tardani95/micromouse_2019/README.md

View this project on [CADLAB.io](https://cadlab.io/project/1610). 

micromouse_2019
