tardani95/micromouse_2019/01_datasheet/imu/schematic.JPG

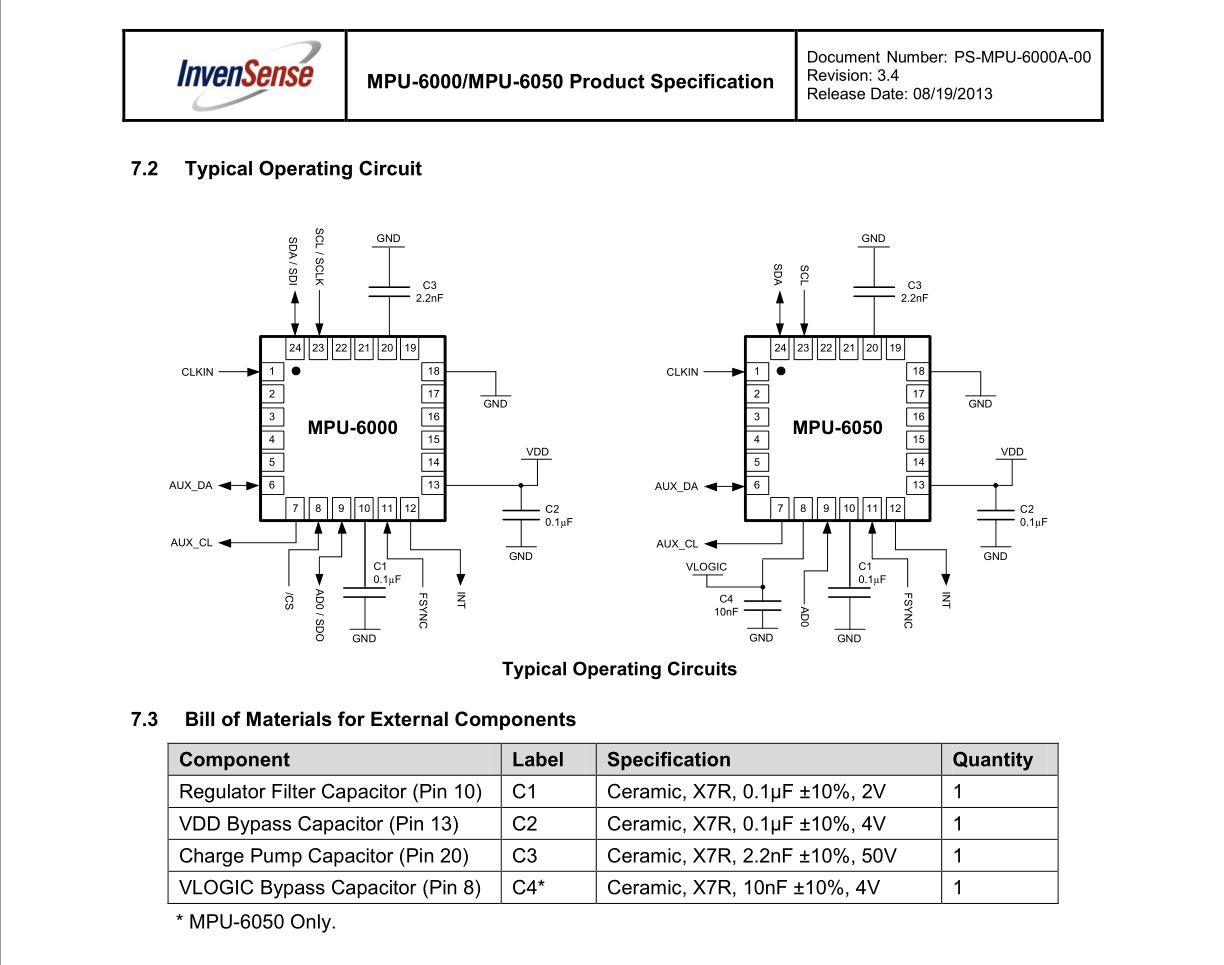
01_datasheet/imu/schematic.JPG
