tardani95/micromouse_2019/01_datasheet/wireless_modul/wifi/esp-12e_pinout.png

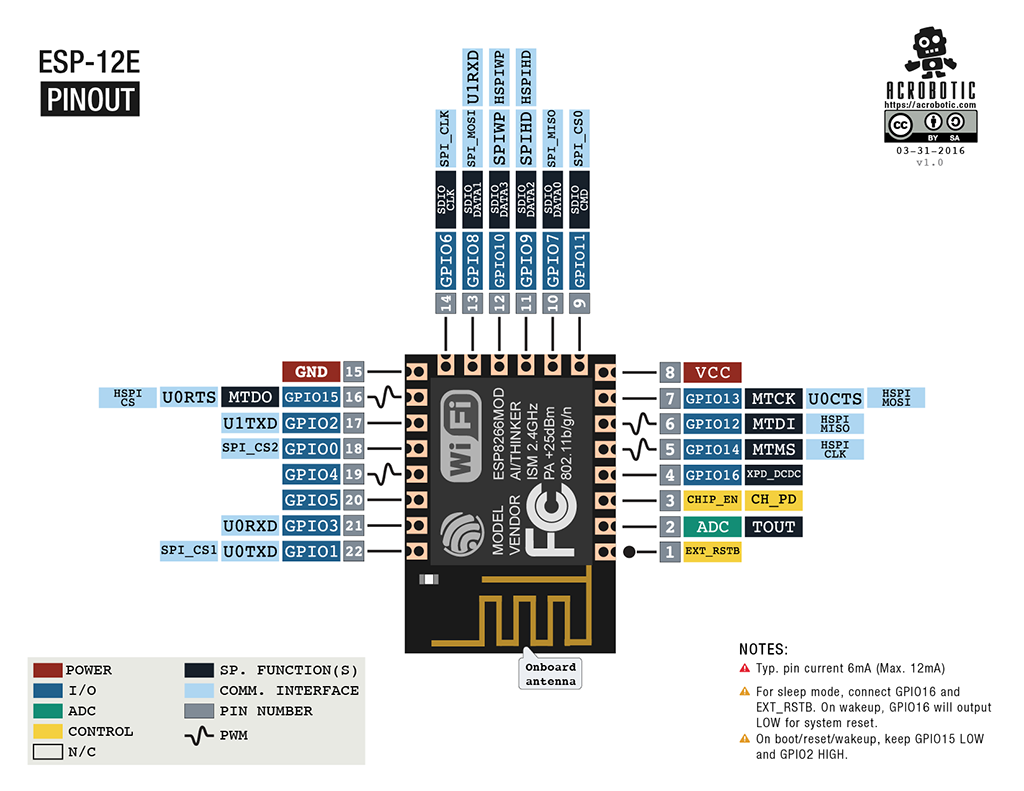
01_datasheet/wireless_modul/wifi/esp-12e_pinout.png
