tardani95/micromouse_2019/03_software/embedded_sw_SPL_C/doc/waldlaeufer_after_run_menu.png

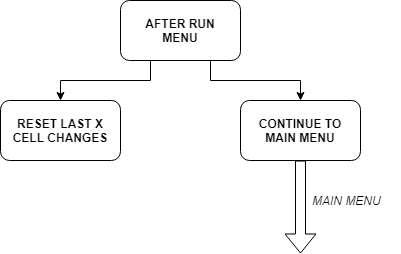
03_software/embedded_sw_SPL_C/doc/waldlaeufer_after_run_menu.png
