tardani95/micromouse_2019/01_datasheet/connectors/connectors.xlsx

 | minek |  |  | nyak |  |  |  | kabel
 | 4x1 - IR_PTR |  |  | BM04B-SRSS-TB (https://lcsc.com/product-detail/Others_JST-Sales-America__JST-Sales-America-BM04B-SRSS-TB-LF-SN_C160390.html) |  |  |  | 04SUR-32S (https://lcsc.com/product-detail/Others_JST-Sales-America_04SUR-32S_JST-Sales-America-04SUR-32S_C160292.html)
 | LCSC Part Number | Manufacture Part Number | Manufacturer | Package | Description | RoHS | Order Qty. | Min\Mult Order Qty. | Unit Price | Order Price | Product Link
conn_motor_wire | C82373 | 02SR-3S | JST Sales America | Piercing connector | PCB Connectors - Headers, Receptacles, Female Sockets Piercing connector RoHS | yes | 10 | 5\5 | 0.1088 | 1.088 | https://lcsc.com/product-detail/Connectors_JST-Sales-America_02SR-3S_JST-Sales-America-02SR-3S_C82373.html
conn_swd_wire | C268118 | 03SR-3S | JST Sales America | P=1mm | PCB Connectors - Headers, Receptacles, Female Sockets P=1mm RoHS | yes | 1 | 1\1 | 0.14 | 0.14 | https://lcsc.com/product-detail/Others_JST-Sales-America_03SR-3S_JST-Sales-America-03SR-3S_C268118.html
conn_batt | C131337 | B2B-PH-K-S(LF)(SN) | JST Sales America | Plugin | PCB Connectors - Headers, Male Pins Plugin RoHS | yes | 5 | 5\5 | 0.1109 | 0.5545 | https://lcsc.com/product-detail/PCB-Connectors-Headers-Male-Pins_JST-Sales-America_B2B-PH-K-S-LF-SN_JST-Sales-America-B2B-PH-K-S-LF-SN_C131337.html
conn_motor_pcb | C160388 | BM02B-SRSS-TB(LF)(SN) | JST Sales America | SMD,P=1mm | PCB Connectors - Headers, Male Pins SMD,P=1mm RoHS | yes | 10 | 1\1 | 0.1305 | 1.305 | https://lcsc.com/product-detail/_JST_BM02B-SRSS-TB-LF-SN_BM02B-SRSS-TB-LF-SN_C160388.html
conn_swd_pcb | C160403 | SM03B-SRSS-TB(LF)(SN)(P) | JST Sales America | - | PCB Connectors - Headers, Male Pins RoHS | yes | 6 | 1\1 | 0.183 | 1.098 | https://lcsc.com/product-detail/Others_JST-Sales-America__JST-Sales-America-SM03B-SRSS-TB-LF-SN-P_C160403.html
stm32f415rg | C124726 | STM32F415RGT6 | STMicroelectronics | LQFP-64_10x10x05P | ST Microelectronics LQFP-64_10x10x05P RoHS | yes | 3 | 1\1 | 7.9466 | 23.8398 | https://lcsc.com/product-detail/ST-Microelectronics_STMicroelectronics_STM32F415RGT6_STM32F415RGT6_C124726.html
backup_IR_led | C111836 | TSAL6100 | Vishay Intertech | Plugin | Infrared (IR) LEDs Plugin RoHS | yes | 10 | 1\1 | 0.0939 | 0.939 | https://lcsc.com/product-detail/Infrared-IR-LEDs_VISHAY_TSAL6100_TSAL6100_C111836.html
 | for daniel tar
testclips | C99184 | 20.135.5 | Changzhou Amass Elec | Test Clip | Test Clips Test Clip RoHS | yes | 1 | 1\1 | 0.5011 | 0.5011 | https://lcsc.com/product-detail/Test-Clips_Changzhou-Amass-Elec-20-135-5_C99184.html
testclips | C99180 | 20.135.1 | Changzhou Amass Elec | Test Clip | Test Clips Test Clip RoHS | yes | 1 | 1\1 | 0.5043 | 0.5043 | https://lcsc.com/product-detail/Test-Clips_Changzhou-Amass-Elec-20-135-1_C99180.html
testclips | C99182 | 20.135.3 | Changzhou Amass Elec | Test Clip | Test Clips Test Clip RoHS | yes | 1 | 1\1 | 0.5027 | 0.5027 | https://lcsc.com/product-detail/Test-Clips_Changzhou-Amass-Elec-20-135-3_C99182.html
testclips | C99183 | 20.135.4 | Changzhou Amass Elec | Test Clip | Test Clips Test Clip RoHS | yes | 1 | 1\1 | 0.5091 | 0.5091 | https://lcsc.com/product-detail/Test-Clips_Changzhou-Amass-Elec-20-135-4_C99183.html
testclips | C99181 | 20.135.2 | Changzhou Amass Elec | Test Clip | Test Clips Test Clip RoHS | yes | 1 | 1\1 | 0.517 | 0.517 | https://lcsc.com/product-detail/Test-Clips_Changzhou-Amass-Elec-20-135-2_C99181.html
