tardani95/micromouse_2019/01_datasheet/encoder/encoders_comparison.xlsx

AMS Magnetic Rotary Position Sensors
Criteria: | Available on Mouser, ABI, >4000 rpm
Model | Resolution | DAEC | Package | Mouser Stock | Mouser Price (EUR) | AMS Sample | Notes
AS5045B | 4096 | No | SSOP-16 | 399 | 12.9 | 0 | currently used
AS5601 | 2048 | No | SOIC-8 | 3424 | 4.06 | 5 | maximum 456 rpm in ABI Mode (Datasheet Page 7)
AS5040 | 1024 | No | SSOP-16 | 12793 | 11.75 | 3
AS5047D | 2048 | Yes | TSSOP-14 | 2758 | 9.44 | 4 | external stray field compensation
