tardani95/micromouse_2019/01_datasheet/wireless_modul/bluetooth/_bluetooth_modules.xlsx

mfr. No. | distributor | price (without TAX) | delivery | datasheet | voltage supply | dimensons (mm) | notes
BH661C-503 | mouser | 8,33 EUR | 7000 HUF | BH661C-503 Datasheet (https://hu.mouser.com/datasheet/2/915/BlueFanBH661C_2bdatasheets-1360478.pdf) | 3.3 V | 11. 0 x 16.7 x 1.9 | dual mode Bluetooth v4.2 with SPP
SPBT3.0DP2 | arrow | 13 EUR | free | datasheet (http://static6.arrow.com/aropdfconversion/2660c6c649f2dce07df3621c833661d77cad4fe4/128279822216958344.pdf) | 3.3 V | 11.6 x 13.5 x 2.9 | Bluetooth v3.0 with SPP
BT33LT (https://www.arrow.de/de-DE/products/bt33lt/amped-rf-technology/) | arrow | 11,09 EUR | free | datasheet (http://static6.arrow.com/aropdfconversion/d2f114f954caf3751a445e852f3ba5c5ad842af6/8890309385789139bt33_datasheet.pdf) | 2.5 V tolarates 3.3V
SPBT2632C2A.AT2 | rs-online | 3300 HUF | 1000 HUF | datasheet (https://docs-emea.rs-online.com/webdocs/1282/0900766b81282479.pdf) | 2.5 V tolarates 3.3V | 11.6 x 13.5 x 2.9 | Bluetooth v3.0 with SPP | Varga Andris-e
JDY-10 | ebay | alredy paid | arrived | not available | 3.3 V | 13.0 x 18.7 x 3.0 | BLE 4.0, no SPP
