tardani95/micromouse_2019/07_3D/gearbox/_ASSEMBLY_getriebe_rechts.SLDASM

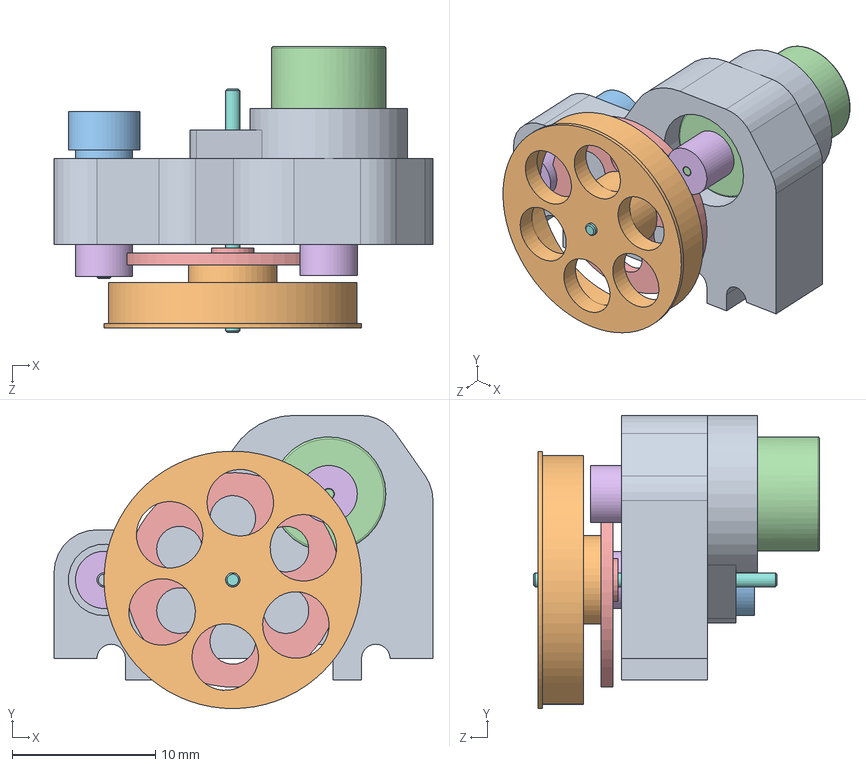
[picture p5: CAD file, 2019-02-14]
07_3D/gearbox/_ASSEMBLY_getriebe_rechts.SLDASM
26.5 x 20.5 x 20.0 mm
getriebe_gehause_rechts
magnetscheibe
magnettraeger
MK06_4R5_1
grossRad
ritzel x 2
rillenkugellager_6488 x 4
hauptWelle
nebenWelle
rad
