tardani95/micromouse_2019/07_3D/3d_print/getriebe_gehause_rechts_2.STEP

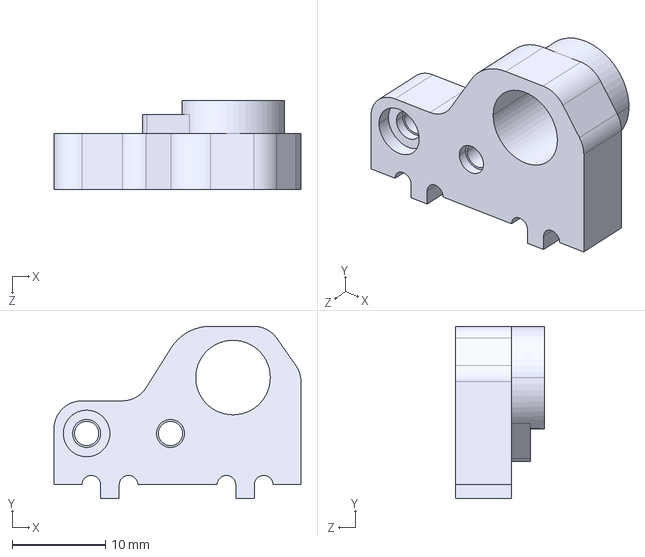
[picture p6: CAD file, 2019-02-14]
07_3D/3d_print/getriebe_gehause_rechts_2.STEP
26.5 x 18.5 x 9.50 mm
