tardani95/micromouse_2019/07_3D/cnc_milling/haz/getriebe_gehause_links_1.STEP

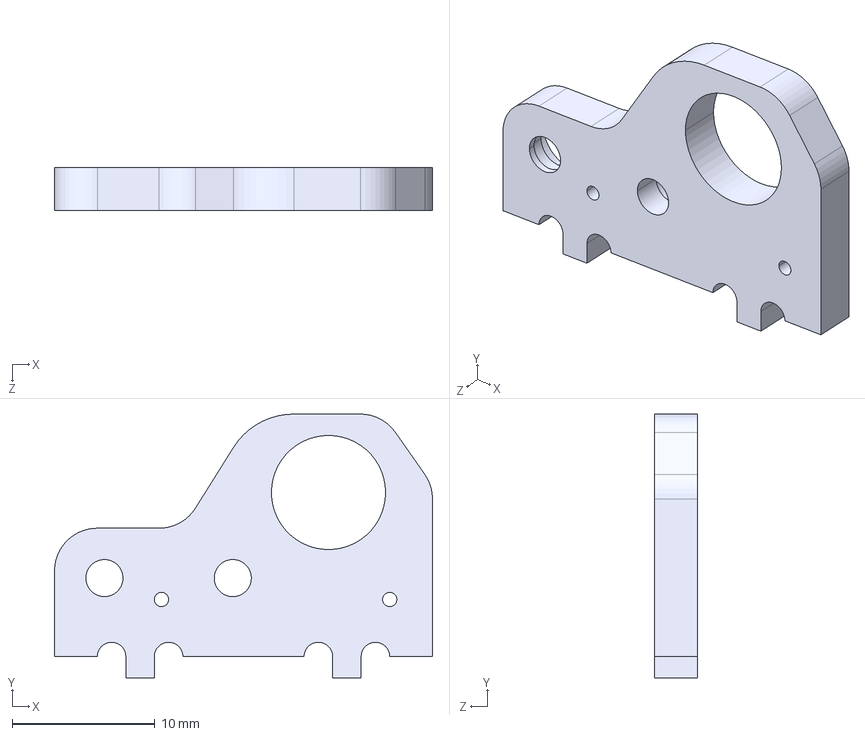
[picture p7: CAD file, 2019-02-14]
07_3D/cnc_milling/haz/getriebe_gehause_links_1.STEP
26.5 x 18.5 x 3.00 mm
