tardani95/micromouse_2019/07_3D/cnc_milling/kerek/rad.SLDPRT

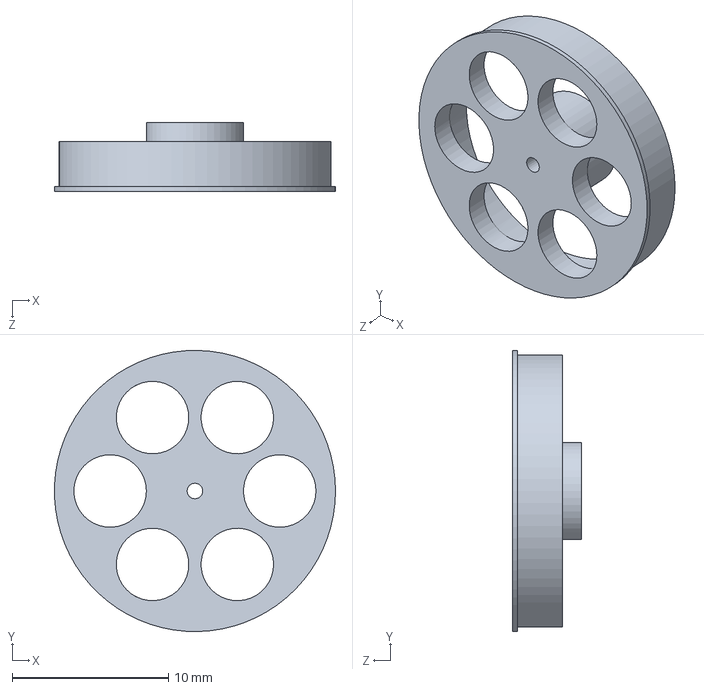
[picture p8: CAD file, 2019-02-14]
07_3D/cnc_milling/kerek/rad.SLDPRT
18.0 x 18.0 x 4.40 mm
