tardani95/micromouse_2019/07_3D/cnc_milling/magnestarto/magnettraeger_aussen.SLDPRT

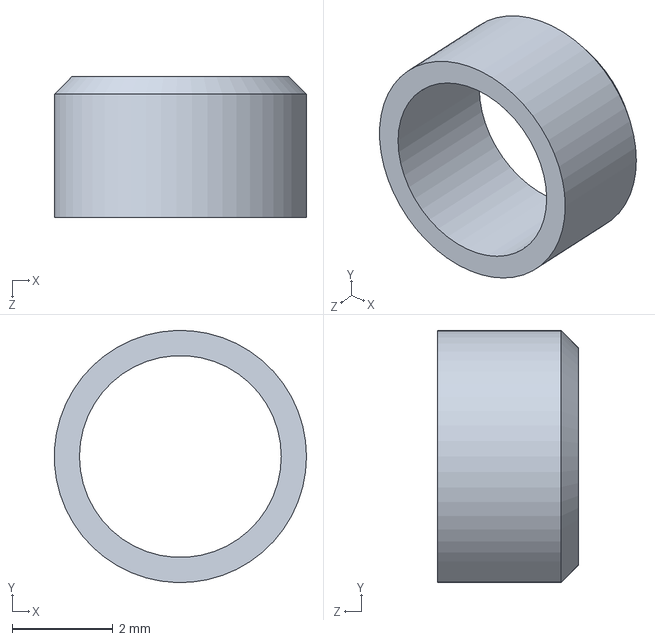
[picture p9: CAD file, 2019-02-14]
07_3D/cnc_milling/magnestarto/magnettraeger_aussen.SLDPRT
5.00 x 5.00 x 2.80 mm
