tardani95/micromouse_2019/07_3D/cnc_milling/STEP_fajlok/magnettraeger_innen.STEP

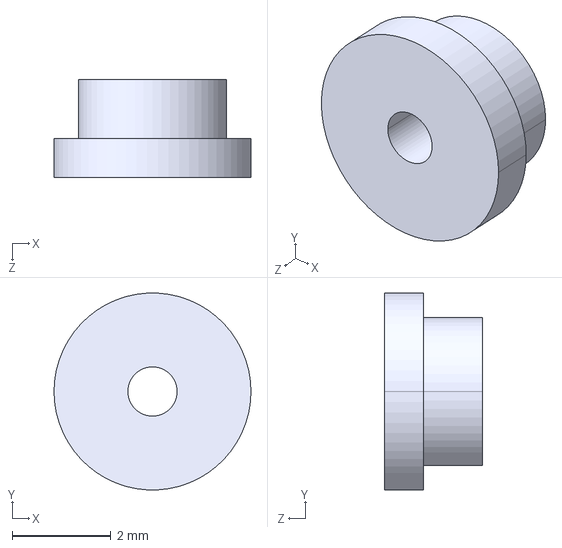
[picture p10: CAD file, 2019-02-14]
07_3D/cnc_milling/STEP_fajlok/magnettraeger_innen.STEP
4.00 x 3.99 x 2.00 mm
