tardani95/micromouse_2019/07_3D/electronic_components/buttons/B3U-3000P.stp

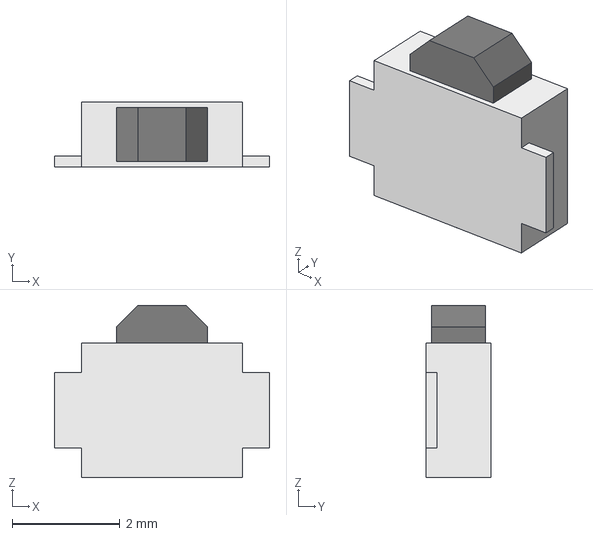
[picture p11: CAD file, 2019-02-14]
07_3D/electronic_components/buttons/B3U-3000P.stp
4.00 x 1.20 x 3.20 mm
