tardani95/micromouse_2019/07_3D/electronic_components/connectors/04SR-3S.STEP

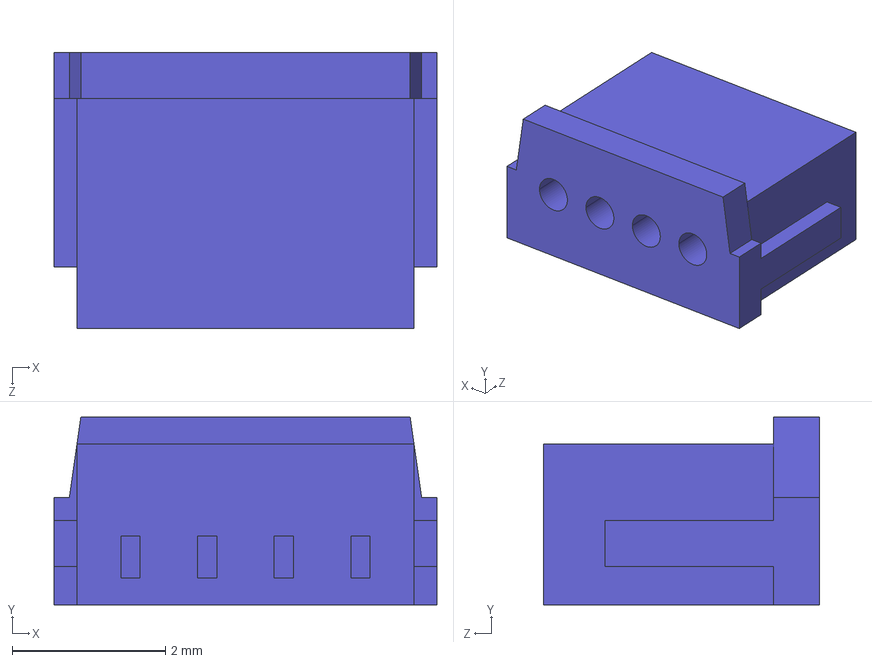
[picture p12: CAD file, 2019-02-21]
07_3D/electronic_components/connectors/04SR-3S.STEP
5.00 x 2.45 x 3.60 mm
