tardani95/micromouse_2019/07_3D/electronic_components/drv8836/DRV8836DSSR.stp

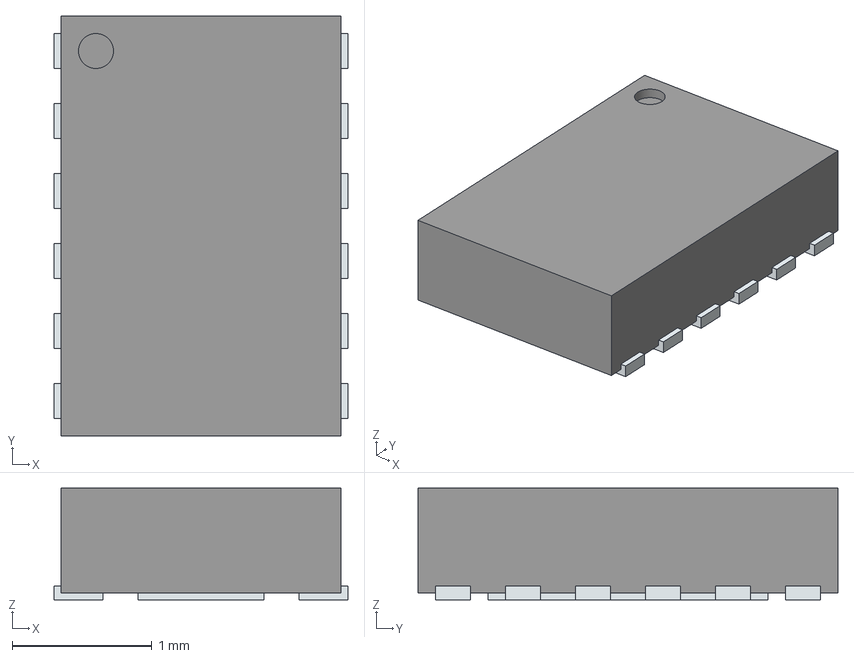
[picture p13: CAD file, 2019-02-14]
07_3D/electronic_components/drv8836/DRV8836DSSR.stp
2.10 x 3.00 x 0.8 mm
ThermalPin
PinsArrayLR
