tardani95/micromouse_2019/07_3D/electronic_components/encoder_modul/micromouse2019_enc v7.step

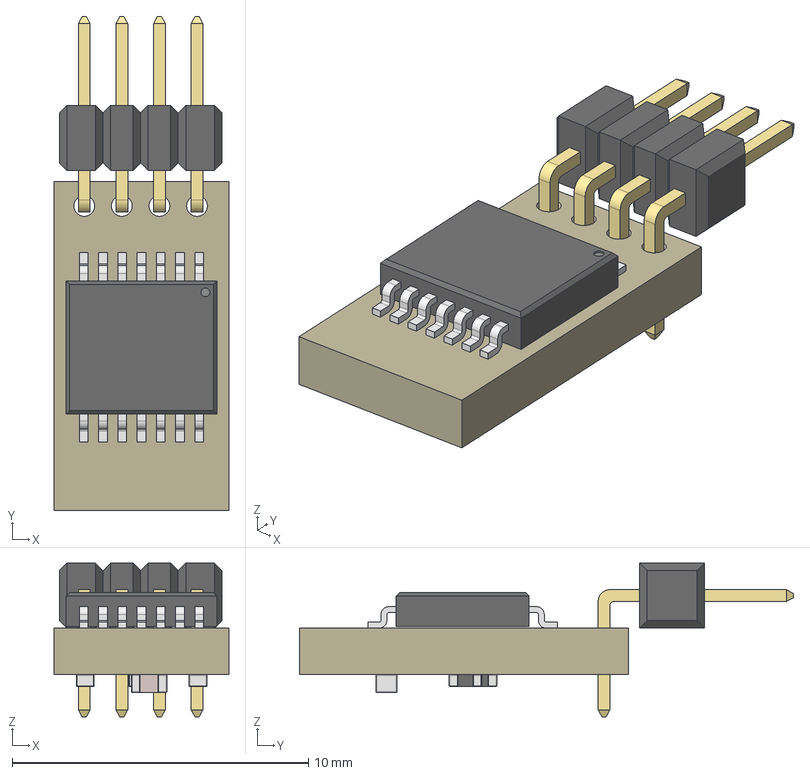
[picture p14: CAD file, 2019-02-26]
07_3D/electronic_components/encoder_modul/micromouse2019_enc v7.step
5.90 x 16.7 x 5.20 mm
Board
10k x 3
100n
AS5047D
CONN_SPI-P127
