tardani95/micromouse_2019/07_3D/electronic_components/led/LED 0606 tri-color.stp

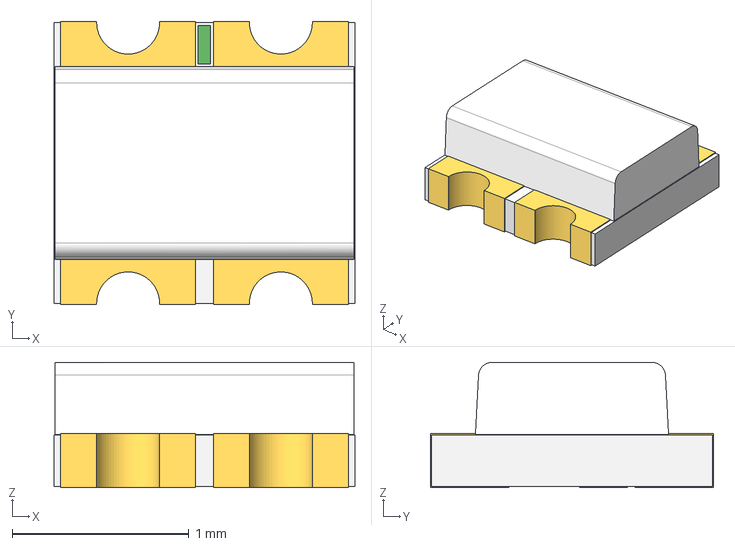
[picture p15: CAD file, 2019-02-26]
07_3D/electronic_components/led/LED 0606 tri-color.stp
1.70 x 1.60 x 0.707 mm
