tardani95/micromouse_2019/07_3D/electronic_components/mcu/STM32F405RGT6.stp

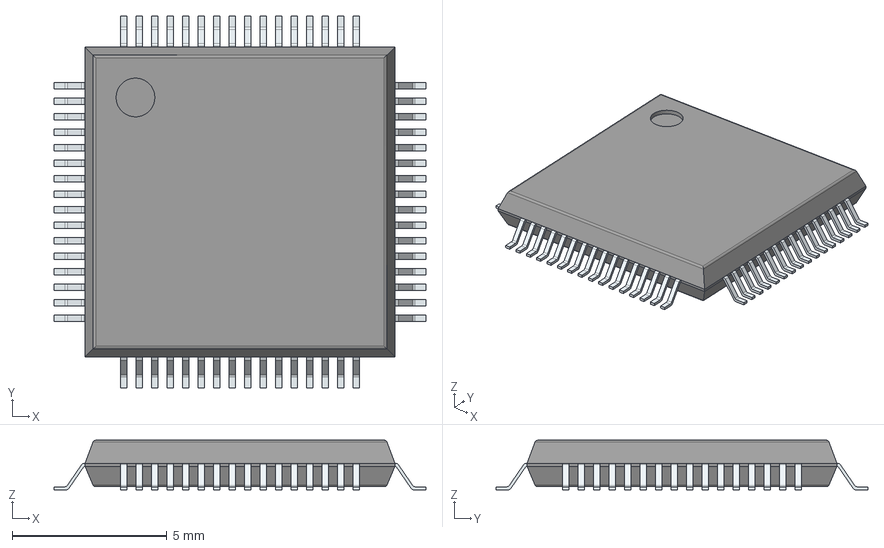
[picture p16: CAD file, 2019-02-14]
07_3D/electronic_components/mcu/STM32F405RGT6.stp
12.0 x 12.0 x 1.60 mm
PinsArrayLR
PinsArrayTB
