tardani95/micromouse_2019/07_3D/electronic_components/power_supply/LDL112PU33R.STEP

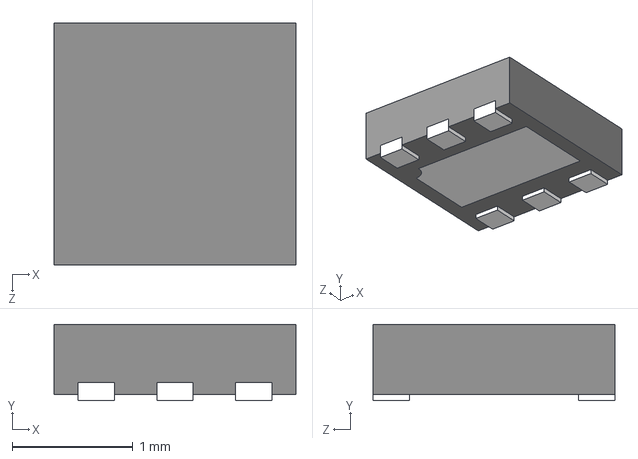
[picture p17: CAD file, 2019-02-21]
07_3D/electronic_components/power_supply/LDL112PU33R.STEP
2.00 x 0.63 x 2.00 mm
