tardani95/micromouse_2019/07_3D/electronic_components/wireless_modul/bluetooth/bc832/BC832--3DModel-STEP-56544.STEP

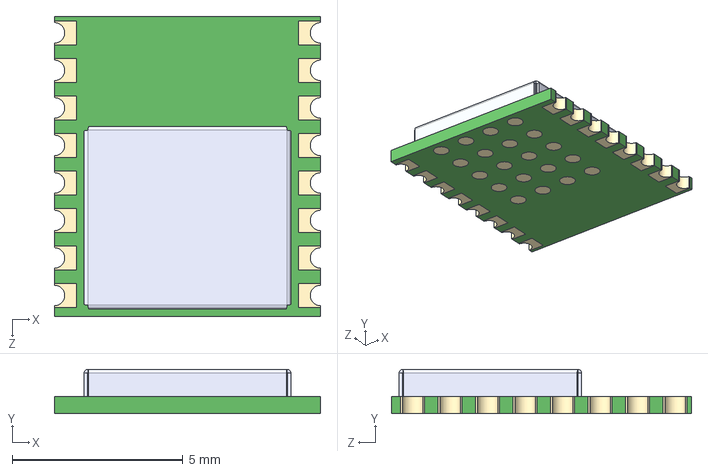
[picture p18: CAD file, 2019-02-19]
07_3D/electronic_components/wireless_modul/bluetooth/bc832/BC832--3DModel-STEP-56544.STEP
7.80 x 1.30 x 8.80 mm
