tardani95/micromouse_2019/07_3D/electronic_components/wireless_modul/bluetooth/jdy-10/JDY-10.stp

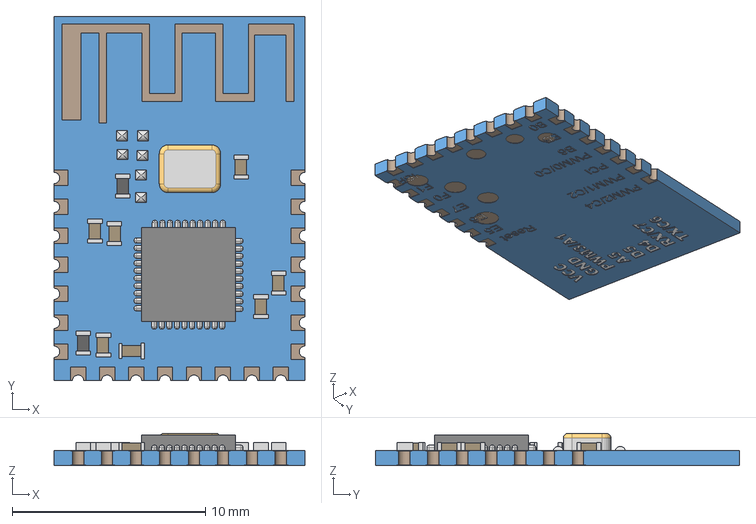
[picture p19: CAD file, 2019-02-19]
07_3D/electronic_components/wireless_modul/bluetooth/jdy-10/JDY-10.stp
13.0 x 18.9 x 1.68 mm
