tardani95/micromouse_2019/07_3D/gearbox/magnetscheibe.SLDPRT

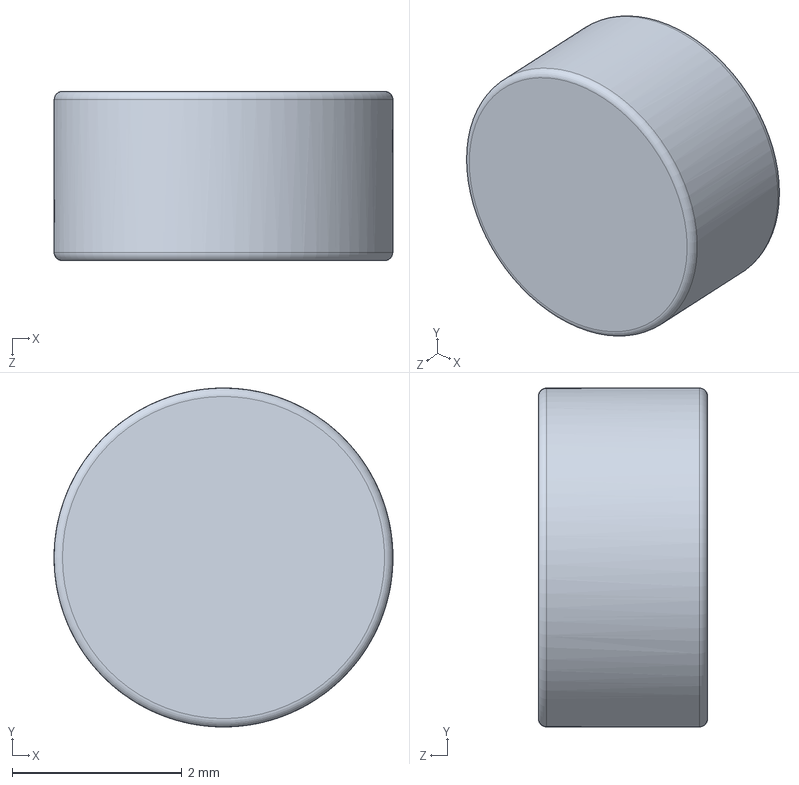
[picture p20: CAD file, 2019-02-14]
07_3D/gearbox/magnetscheibe.SLDPRT
4.00 x 4.00 x 2.00 mm
