tardani95/micromouse_2019/07_3D/3d_print/rad_4.STEP

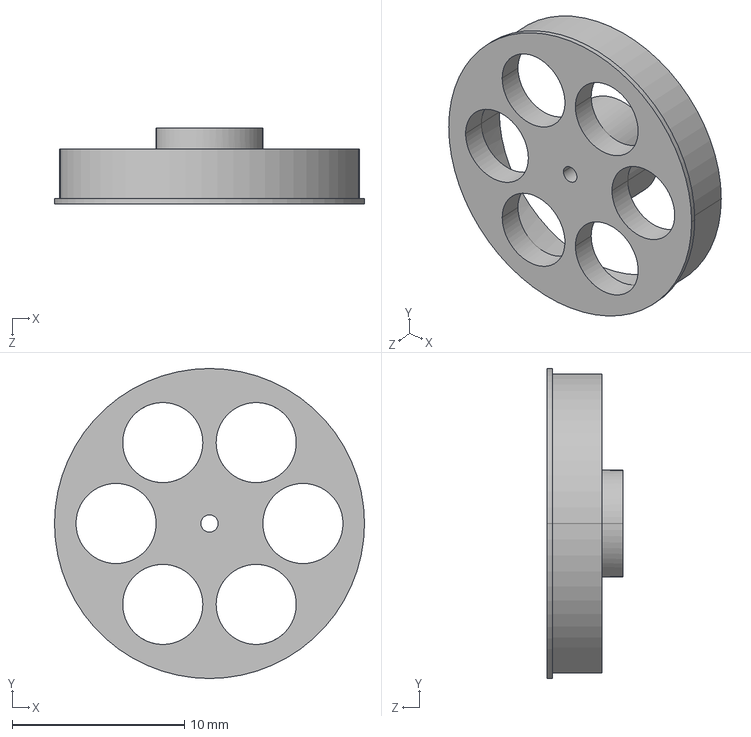
[picture p21: CAD file, 2019-02-14]
07_3D/3d_print/rad_4.STEP
18.0 x 18.0 x 4.40 mm
