tardani95/micromouse_2019/07_3D/electronic_components/buttons/B3U-1000P.stp

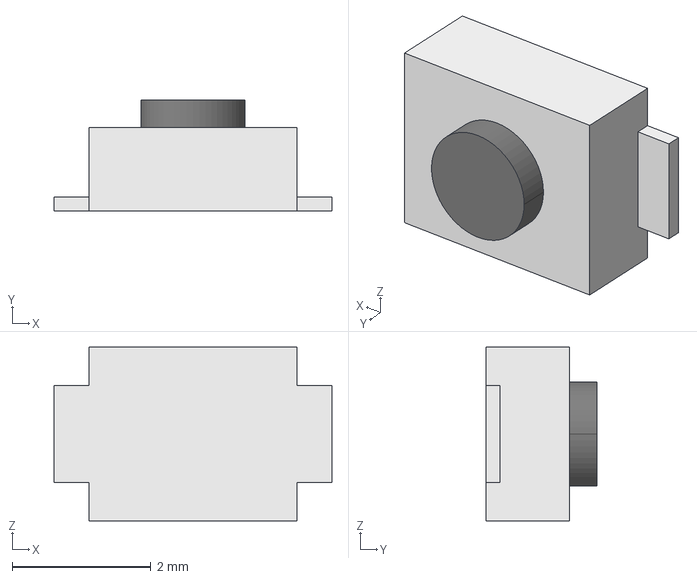
[picture p22: CAD file, 2019-02-14]
07_3D/electronic_components/buttons/B3U-1000P.stp
4.00 x 1.60 x 2.50 mm
