tardani95/micromouse_2019/07_3D/electronic_components/connectors/02SR-3S.STEP

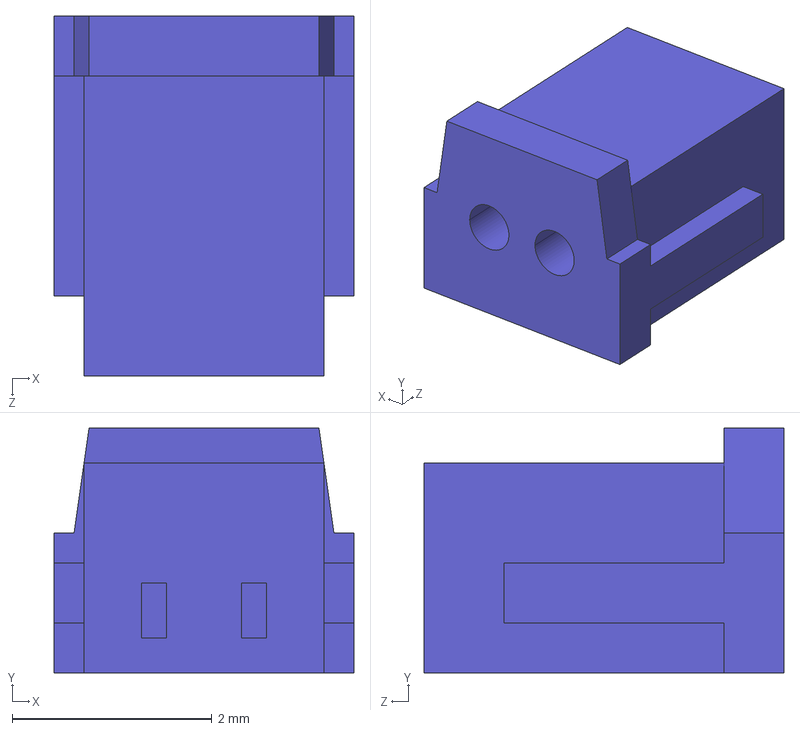
[picture p23: CAD file, 2019-02-21]
07_3D/electronic_components/connectors/02SR-3S.STEP
3.00 x 2.45 x 3.60 mm
