tardani95/micromouse_2019/07_3D/gearbox/grossRad.SLDPRT

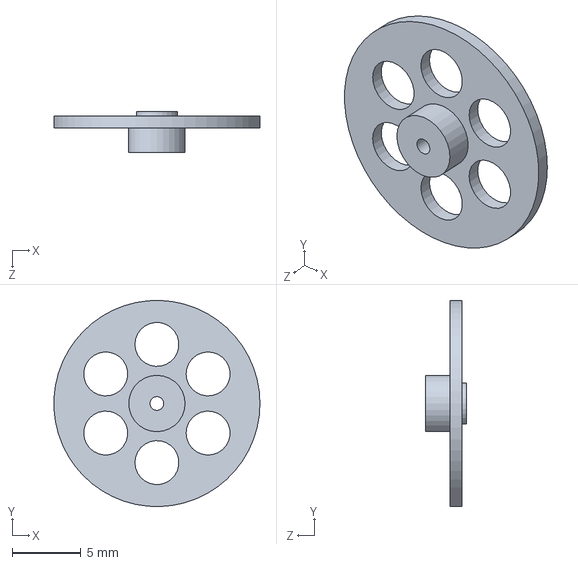
[picture p24: CAD file, 2019-02-14]
07_3D/gearbox/grossRad.SLDPRT
15.0 x 15.0 x 3.00 mm
