tardani95/micromouse_2019/07_3D/3d_print/magnettraeger_4.STEP

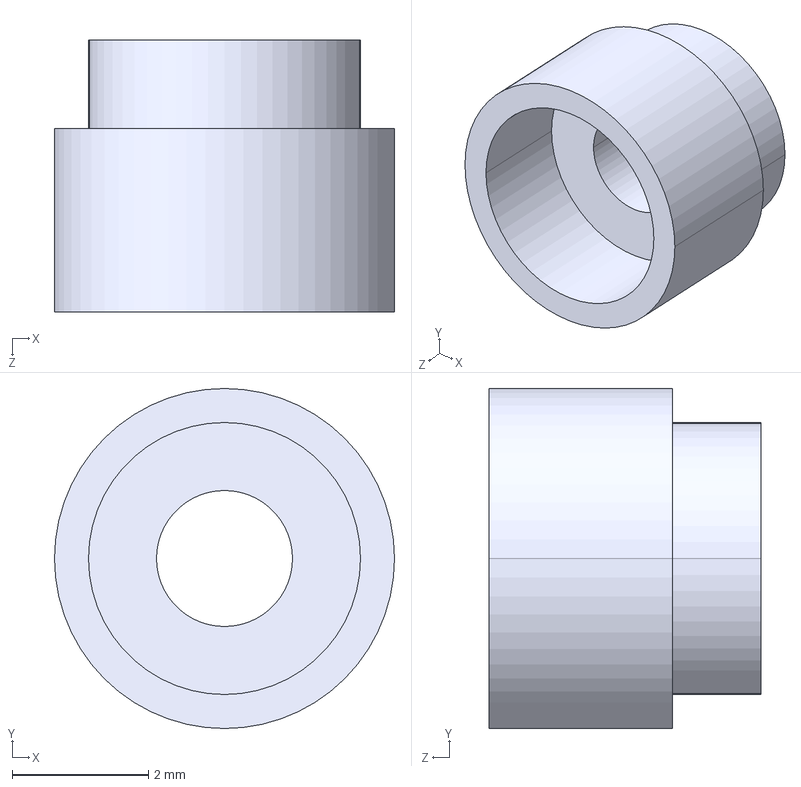
[picture p25: CAD file, 2019-02-14]
07_3D/3d_print/magnettraeger_4.STEP
5.00 x 5.00 x 4.00 mm
