tardani95/micromouse_2019/07_3D/cnc_milling/haz/getriebe_gehause_rechts_2.STEP

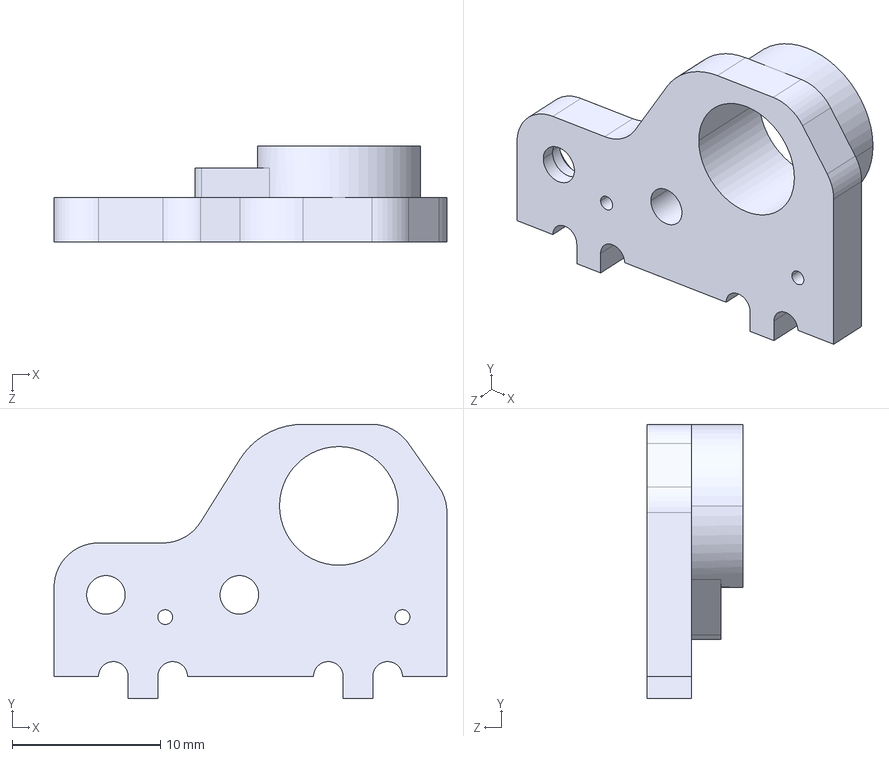
[picture p26: CAD file, 2019-02-14]
07_3D/cnc_milling/haz/getriebe_gehause_rechts_2.STEP
26.5 x 18.5 x 6.50 mm
