tardani95/micromouse_2019/07_3D/electronic_components/connectors/03SR-3S.STEP

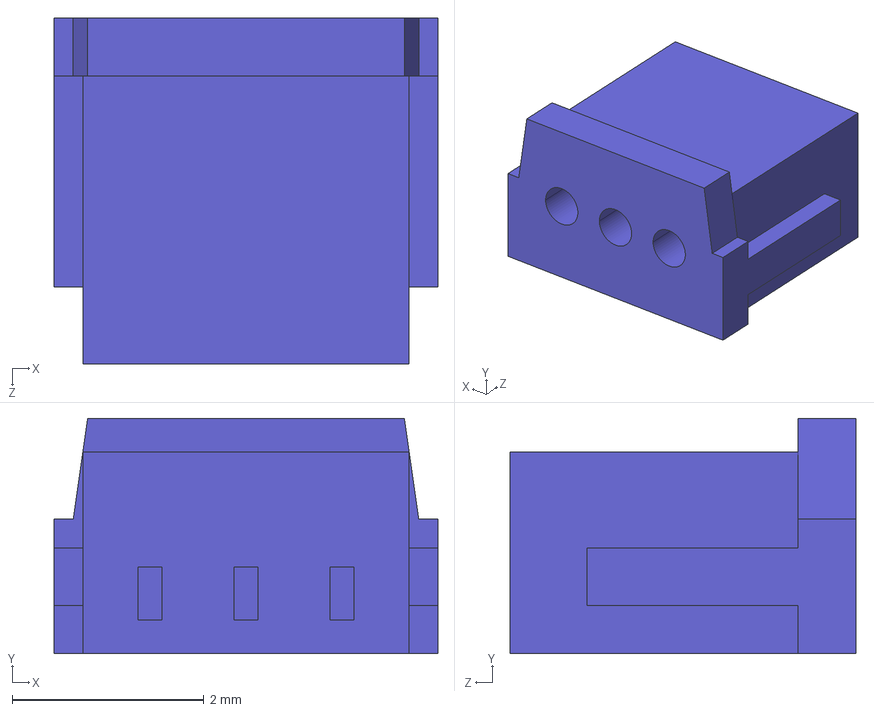
[picture p27: CAD file, 2019-02-21]
07_3D/electronic_components/connectors/03SR-3S.STEP
4.00 x 2.45 x 3.60 mm
