tardani95/micromouse_2019/07_3D/electronic_components/encoder_modul/encoder_pcb_fusion_v4.step

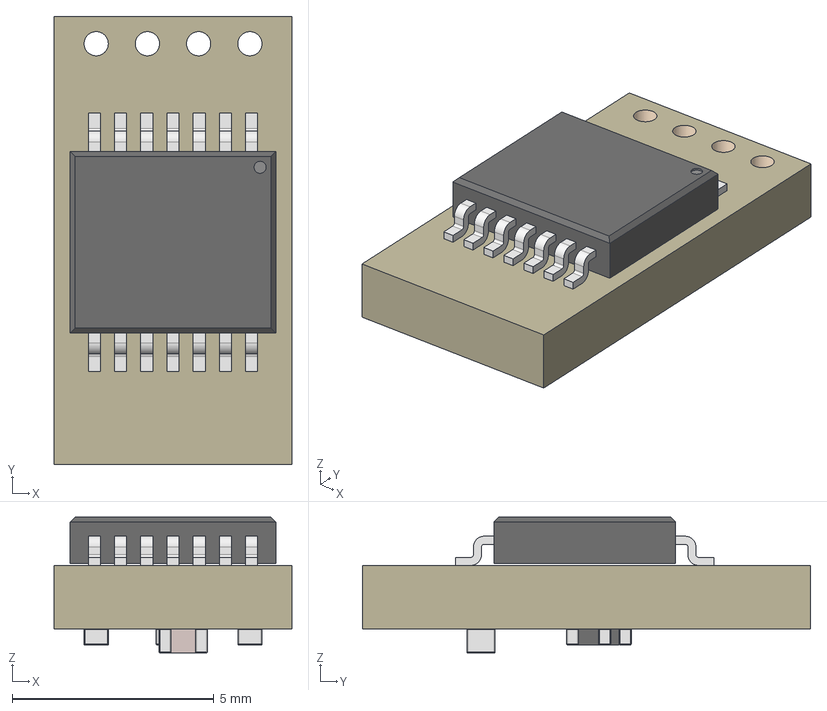
[picture p28: CAD file, 2019-02-26]
07_3D/electronic_components/encoder_modul/encoder_pcb_fusion_v4.step
5.90 x 11.1 x 3.37 mm
Board
10k x 3
100n
AS5047D
ENC_PORT_MODULE
