tardani95/micromouse_2019/07_3D/gearbox/ritzel.SLDPRT

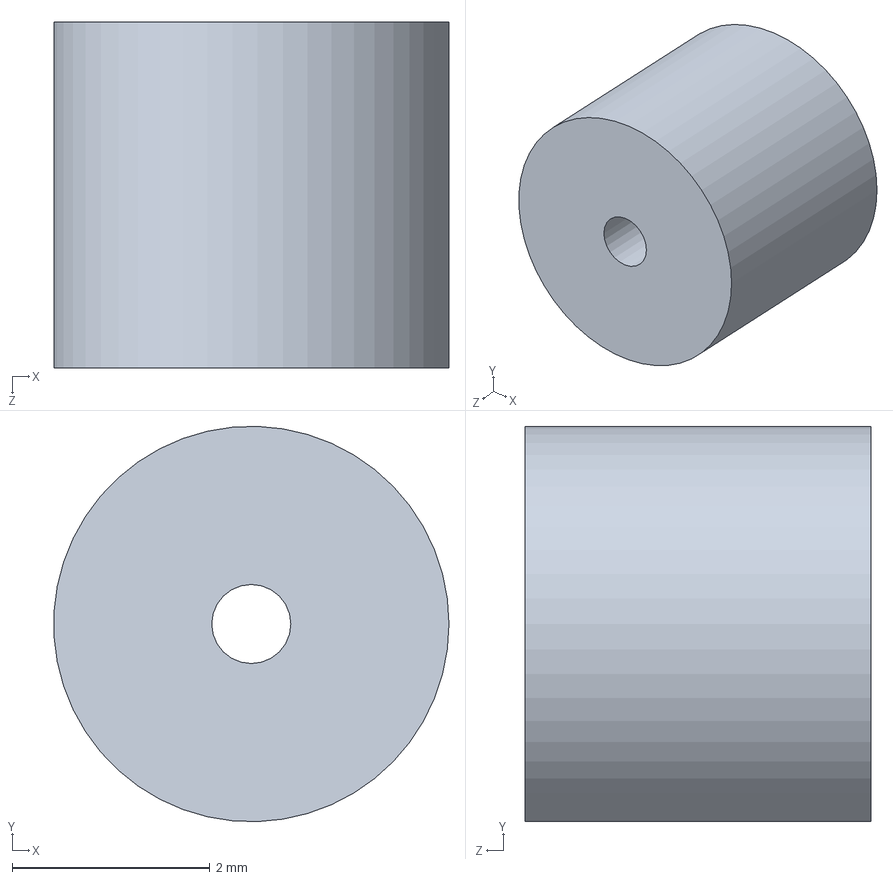
[picture p29: CAD file, 2019-02-14]
07_3D/gearbox/ritzel.SLDPRT
4.00 x 4.00 x 3.50 mm
