tardani95/micromouse_2019/07_3D/electronic_components/connectors/SM03B-SRSS-TB.STEP

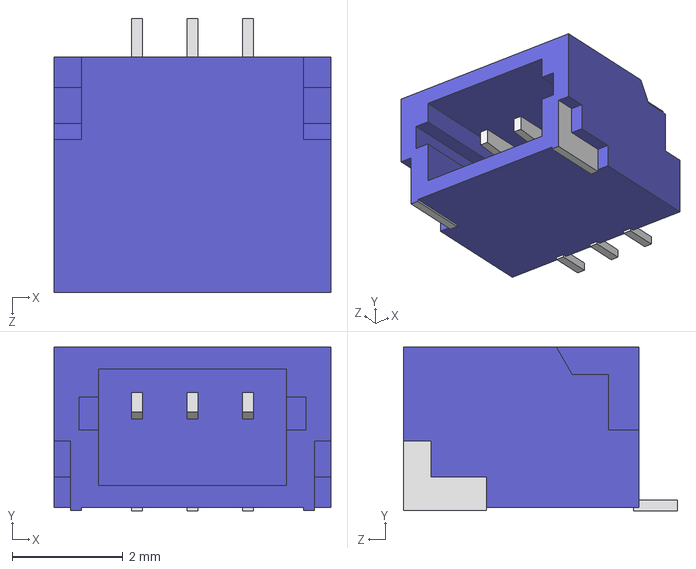
[picture p30: CAD file, 2019-02-21]
07_3D/electronic_components/connectors/SM03B-SRSS-TB.STEP
5.00 x 2.96 x 4.95 mm
