tardani95/micromouse_2019/07_3D/electronic_components/connectors/BM02B-SRSS-TB.STEP

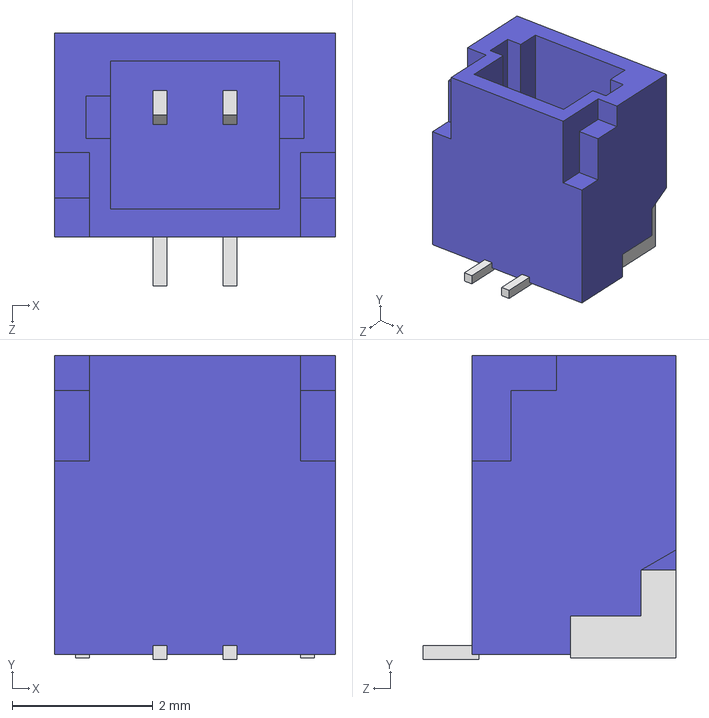
[picture p31: CAD file, 2019-02-21]
07_3D/electronic_components/connectors/BM02B-SRSS-TB.STEP
4.00 x 4.32 x 3.60 mm
