tardani95/micromouse_2019/07_3D/electronic_components/connectors/BM04B-SRSS-TB.STEP

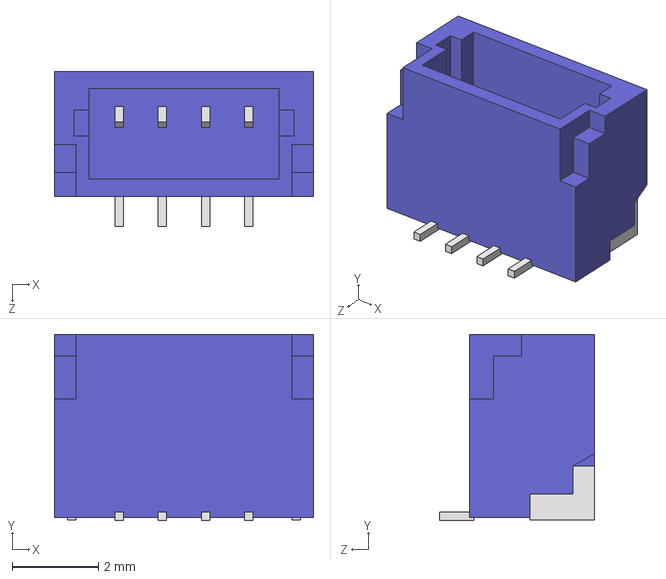
[picture p32: CAD file, 2019-02-21]
07_3D/electronic_components/connectors/BM04B-SRSS-TB.STEP
6.00 x 4.32 x 3.60 mm
