tardani95/micromouse_2019/07_3D/gearbox/hauptWelle.SLDPRT

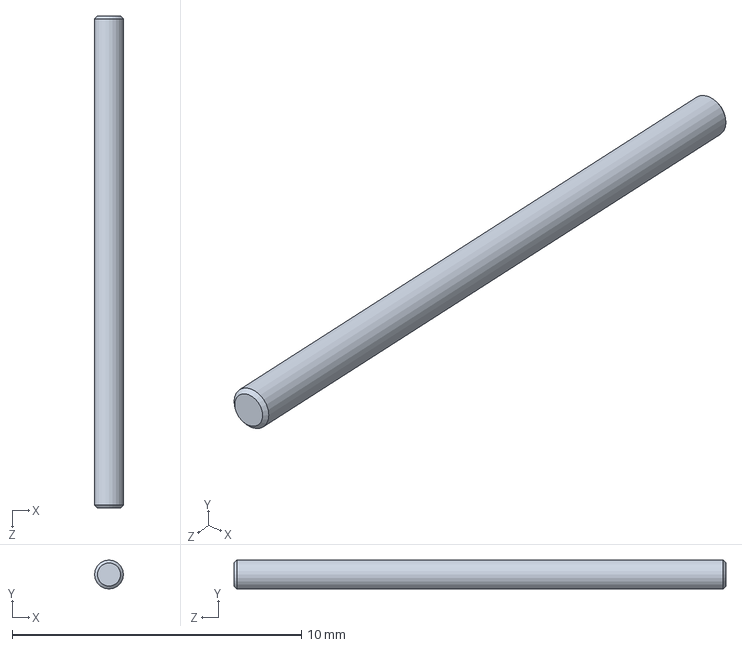
[picture p33: CAD file, 2019-02-14]
07_3D/gearbox/hauptWelle.SLDPRT
1.00 x 1.00 x 17.0 mm
