tardani95/micromouse_2019/07_3D/electronic_components/connectors/B2B-PH-K-S(LF)(SN)--3DModel-STEP-56544.STEP

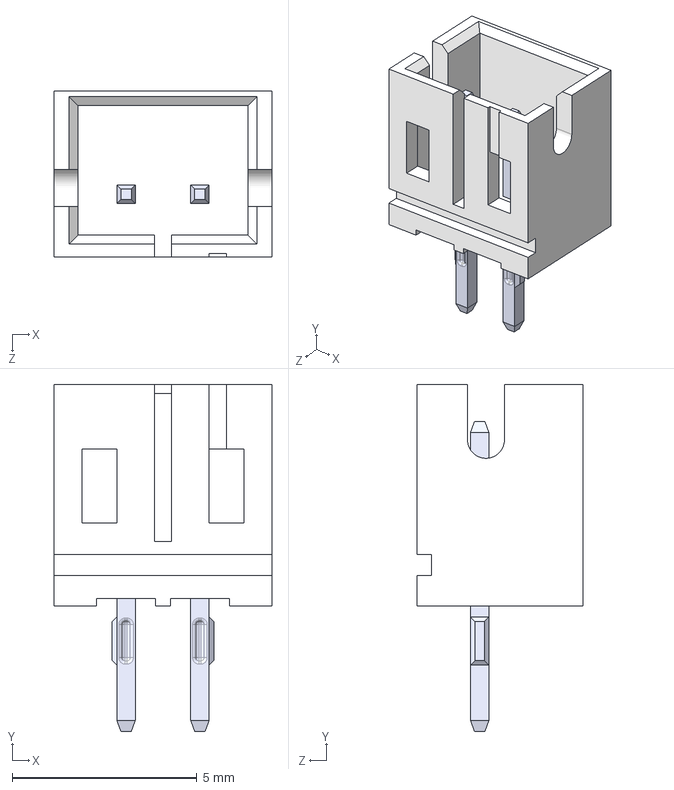
[picture p34: CAD file, 2019-02-21]
07_3D/electronic_components/connectors/B2B-PH-K-S(LF)(SN)--3DModel-STEP-56544.STEP
5.90 x 9.40 x 4.50 mm
