tardani95/micromouse_2019/07_3D/gearbox/MK06_4R5_1.SLDPRT

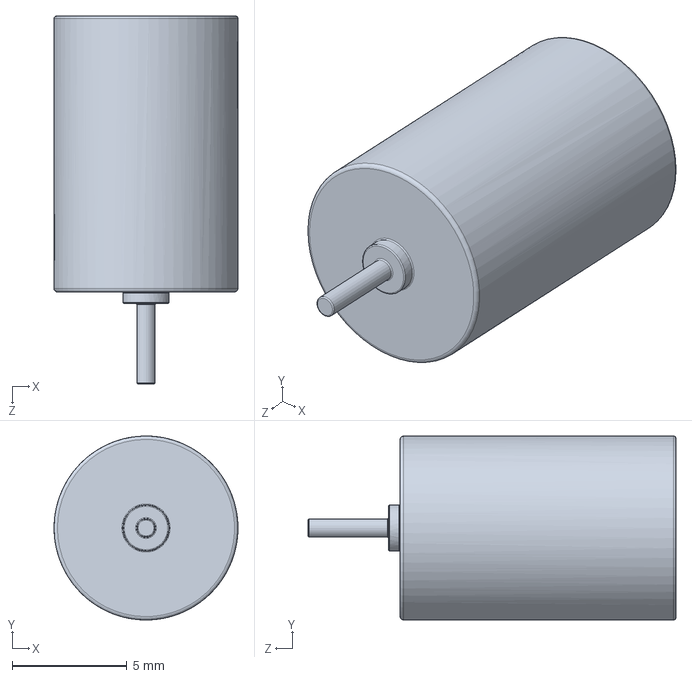
[picture p35: CAD file, 2019-02-14]
07_3D/gearbox/MK06_4R5_1.SLDPRT
8.00 x 8.00 x 16.0 mm
