tardani95/micromouse_2019/07_3D/gearbox/nebenWelle.SLDPRT

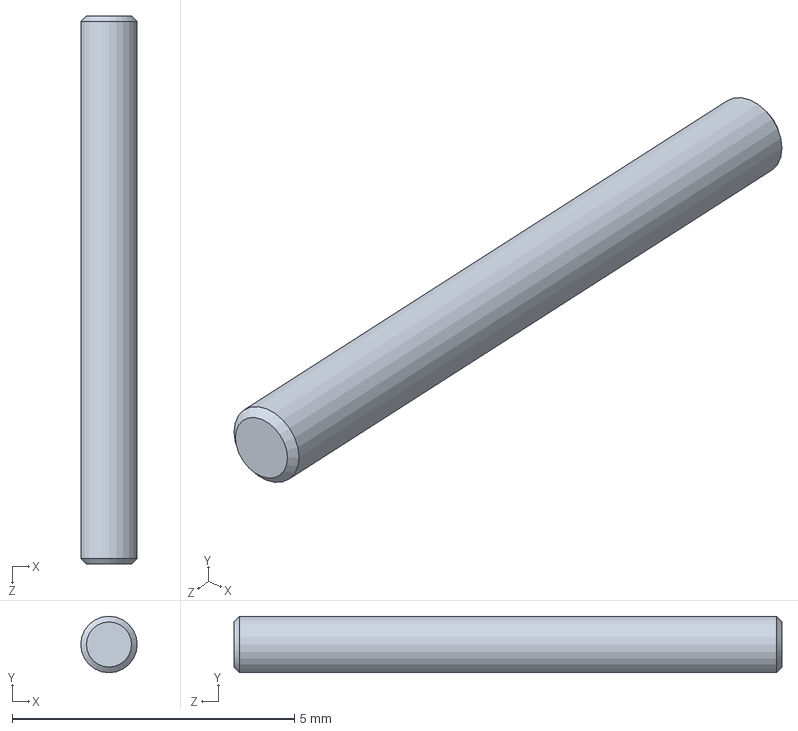
[picture p36: CAD file, 2019-02-14]
07_3D/gearbox/nebenWelle.SLDPRT
1.00 x 1.00 x 9.70 mm
