tardani95/micromouse_2019/07_3D/gearbox/rillenkugellager_6488.SLDPRT

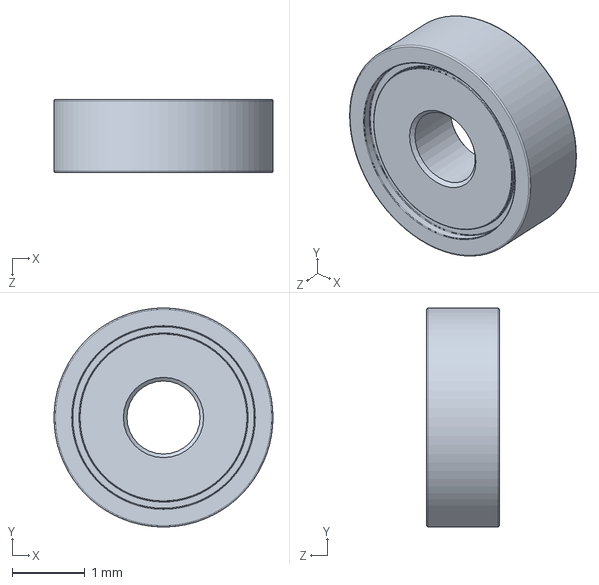
[picture p37: CAD file, 2019-02-14]
07_3D/gearbox/rillenkugellager_6488.SLDPRT
3.00 x 3.00 x 1 mm
