tardani95/micromouse_2019/(list of files, cad)

Other CAD files:
07_3D/cnc_milling/haz/getriebe_gehause_rechts_1.STEP
07_3D/cnc_milling/magnestarto/magnettraeger_innen.SLDPRT
07_3D/electronic_components/encoder_modul/micromouse2019_enc v6.stl
07_3D/cnc_milling/STEP_fajlok/rad.STEP
07_3D/3d_print/getriebe_gehause_links_2.STEP
07_3D/cnc_milling/haz/getriebe_gehause_links_2.STEP
07_3D/gearbox/getriebe_gehause_rechts.SLDPRT
07_3D/cnc_milling/STEP_fajlok/getriebe_gehause_links_2.STEP
07_3D/cnc_milling/STEP_fajlok/getriebe_gehause_rechts_1.STEP
07_3D/cnc_milling/STEP_fajlok/magnettraeger_aussen.STEP
07_3D/gearbox/rad.SLDPRT
07_3D/gearbox/getriebe_gehause_links.SLDPRT
07_3D/gearbox/magnettraeger.SLDPRT
07_3D/cnc_milling/haz/getriebe_gehause_links_1.SLDPRT
07_3D/cnc_milling/haz/getriebe_gehause_links_2.SLDPRT
07_3D/cnc_milling/haz/getriebe_gehause_rechts_1.SLDPRT
07_3D/cnc_milling/haz/getriebe_gehause_rechts_2.SLDPRT
07_3D/electronic_components/drv8836/DRV8836DSSR.stl
07_3D/led_holder/led_holder_v11.ipt
07_3D/led_holder/led_holder_v12.ipt
07_3D/led_holder/led_holder_v13.ipt
