tardani95/micromouse_2019/02_pcb/mouse_2017_wErrors.pdf

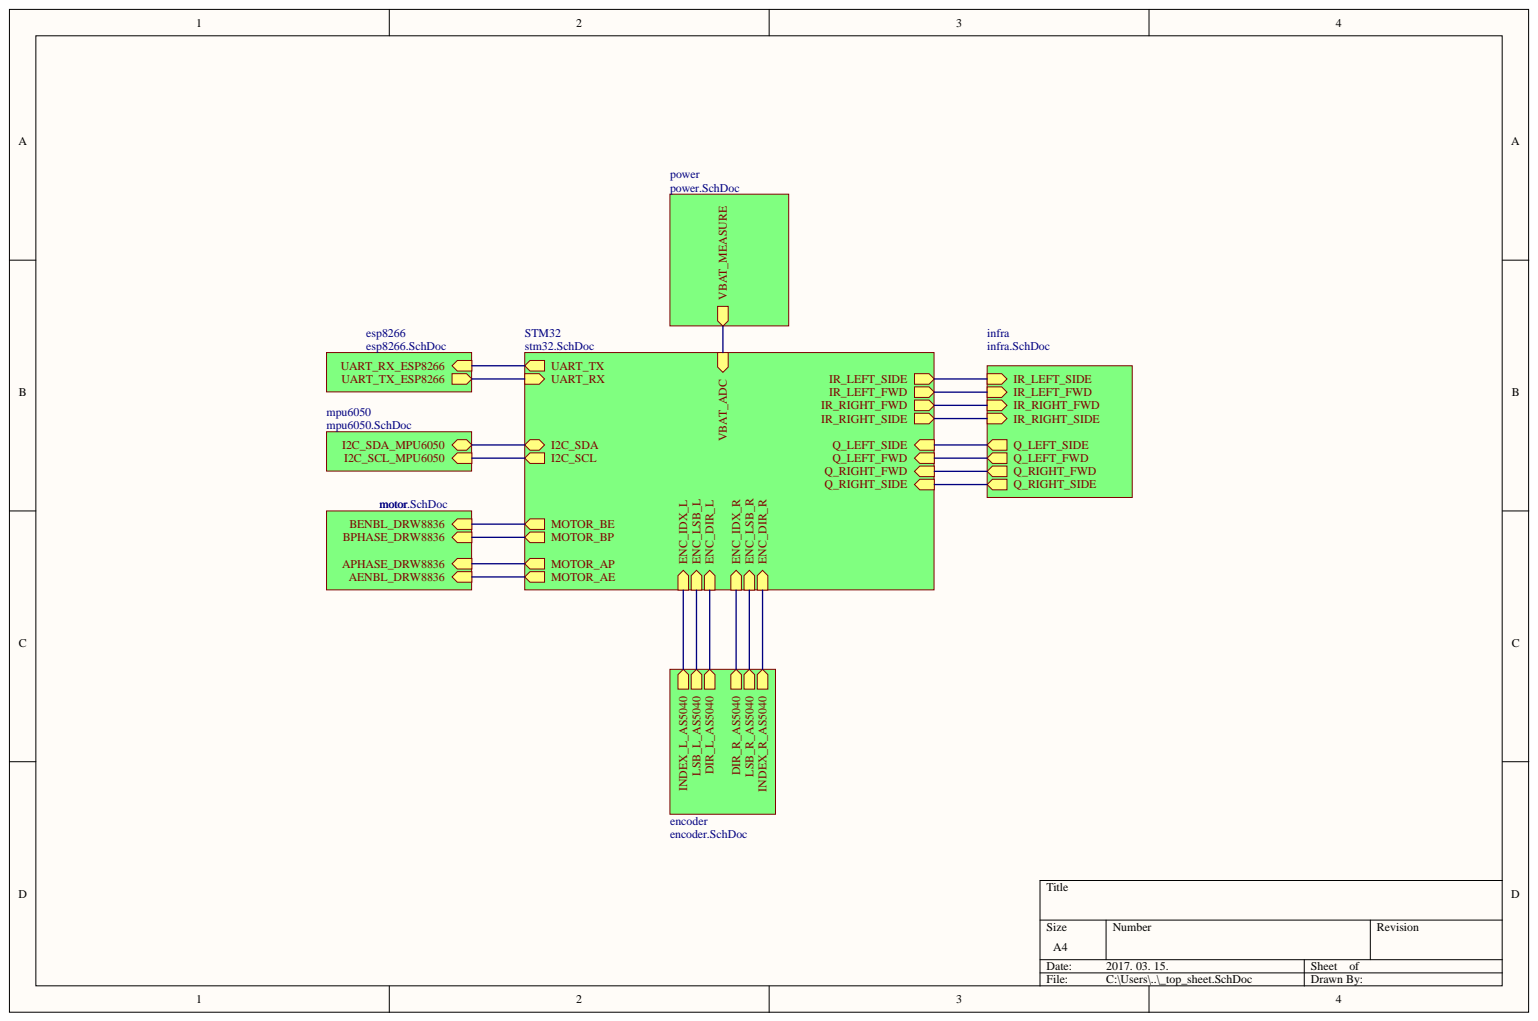
[picture p38: page 1]

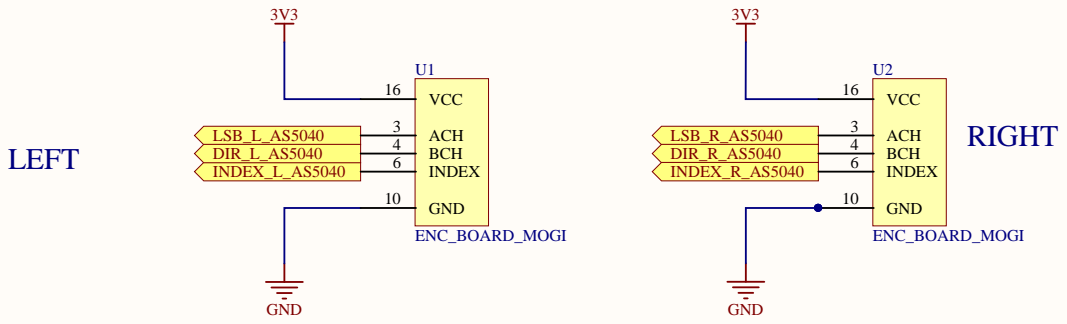
[picture p39: page 2]

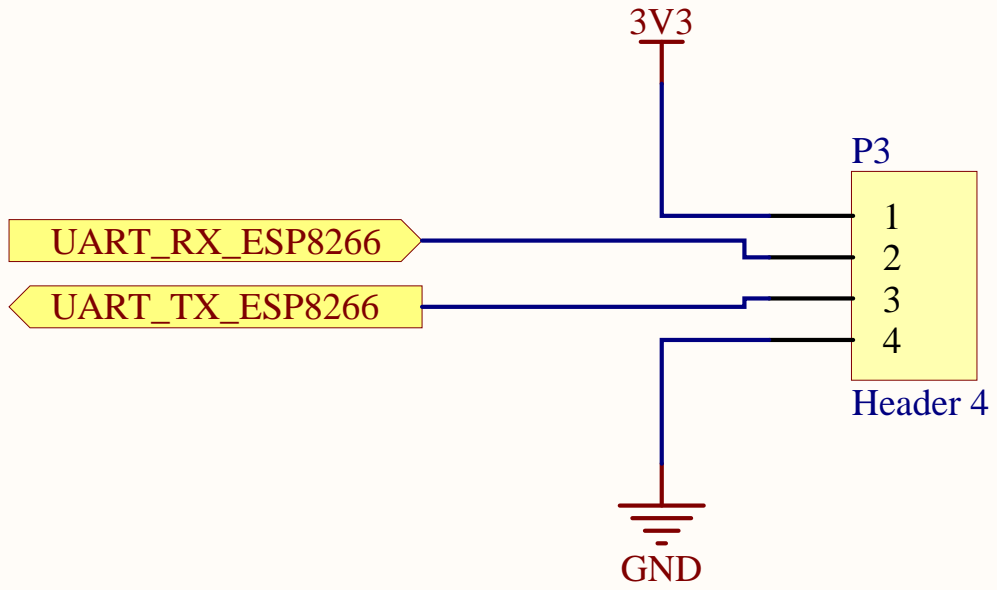
[picture p40: page 3]

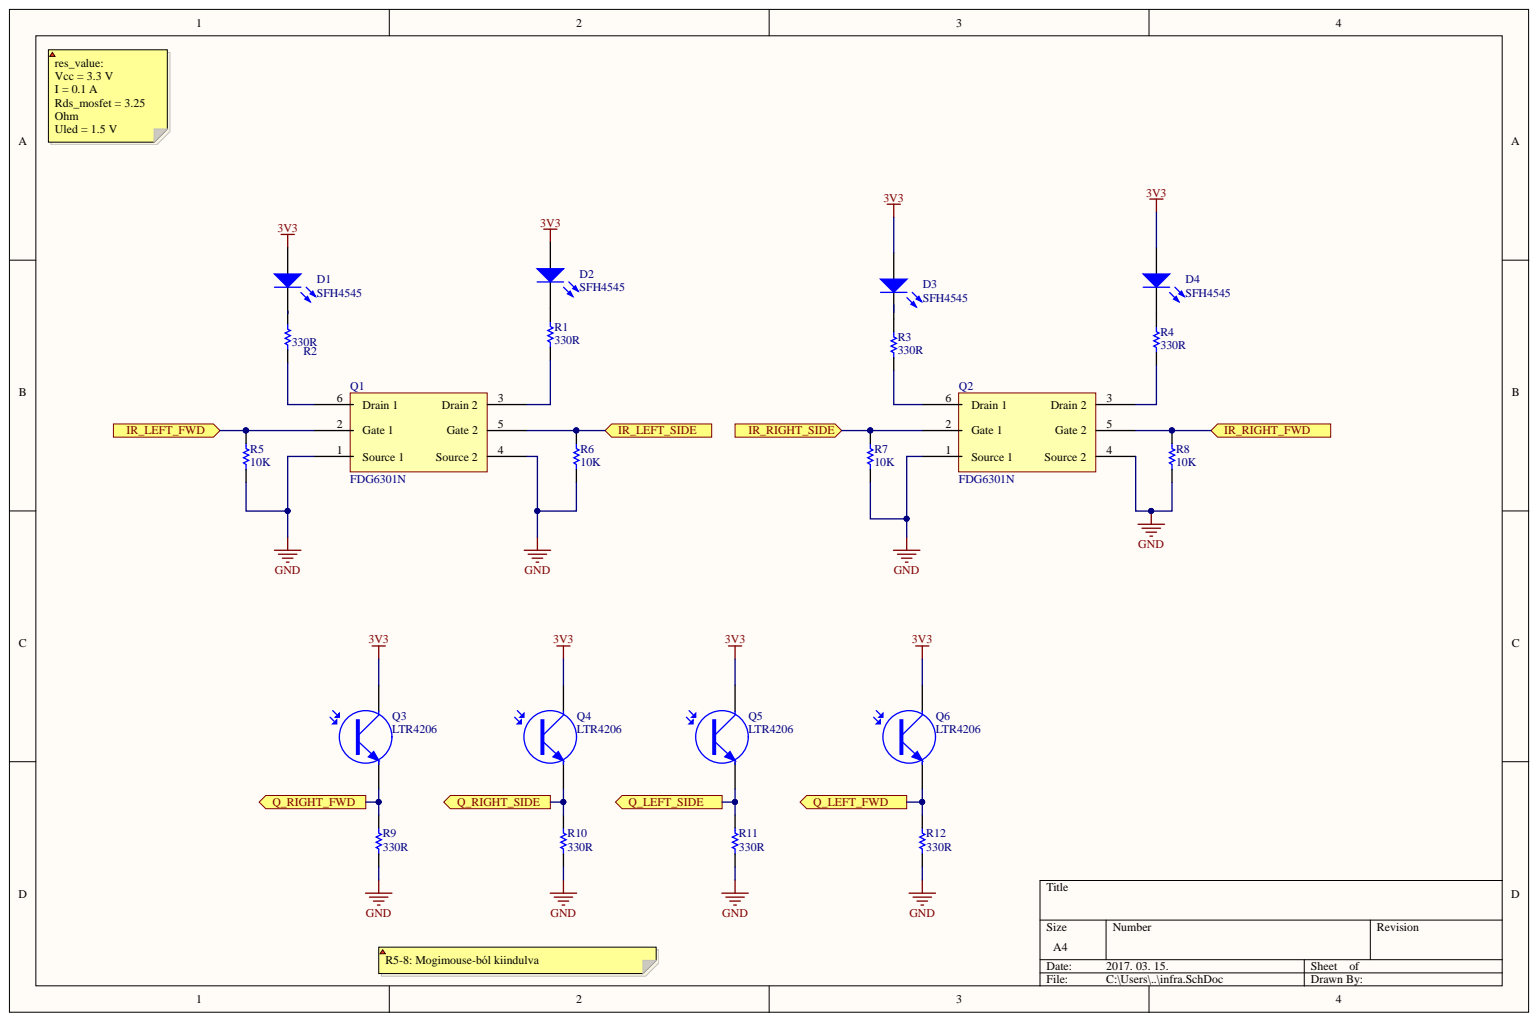
[picture p41: page 4]

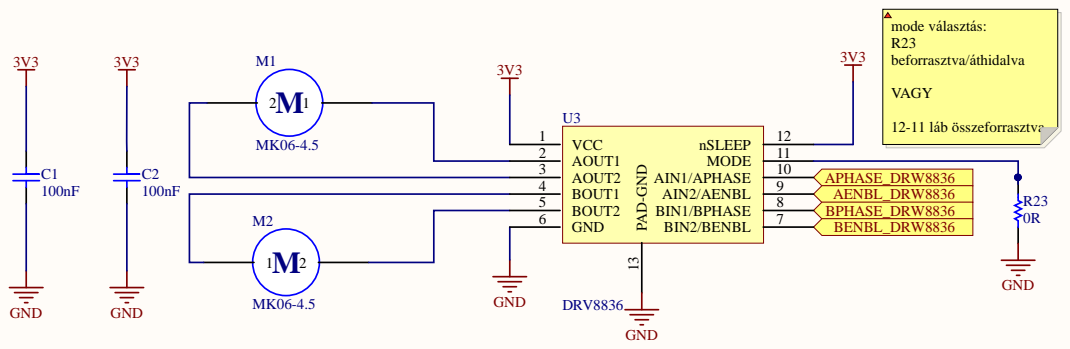
[picture p42: page 5]

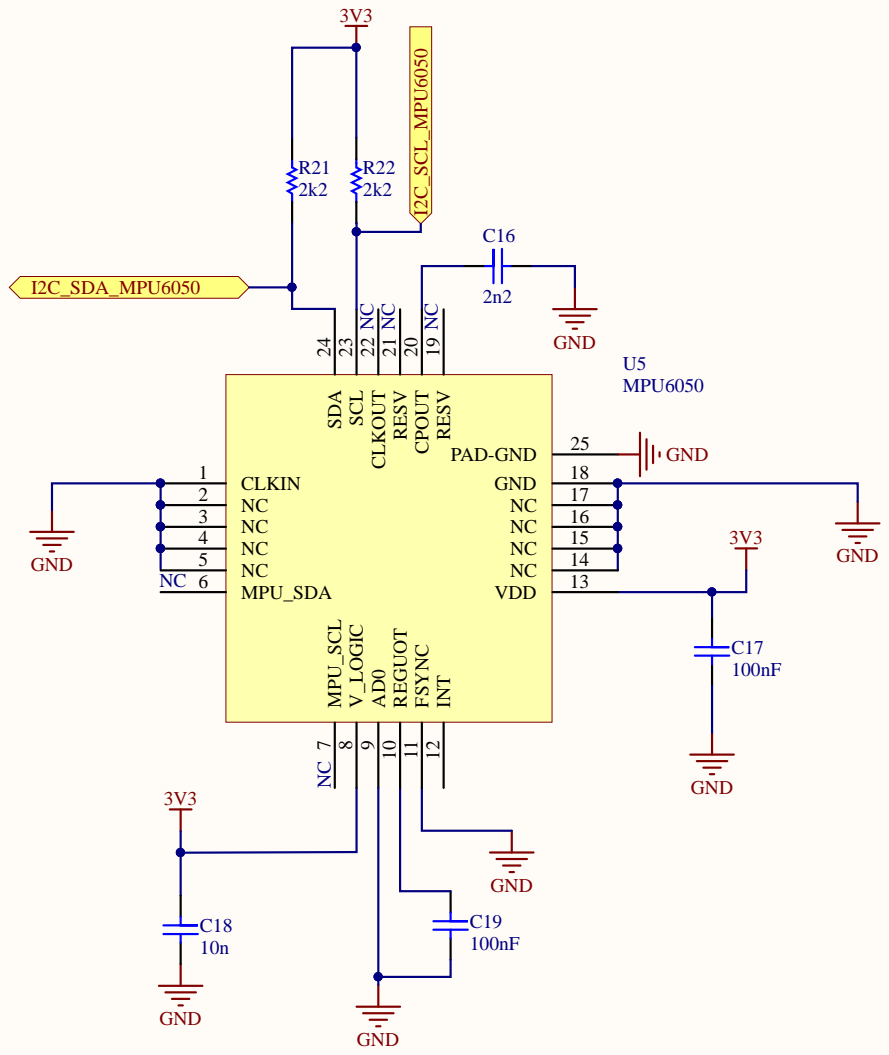
[picture p43: page 6]

RESV 19 CPOUT 20 RESV 21 CLKOUT 22 SCL 23 SDA 24

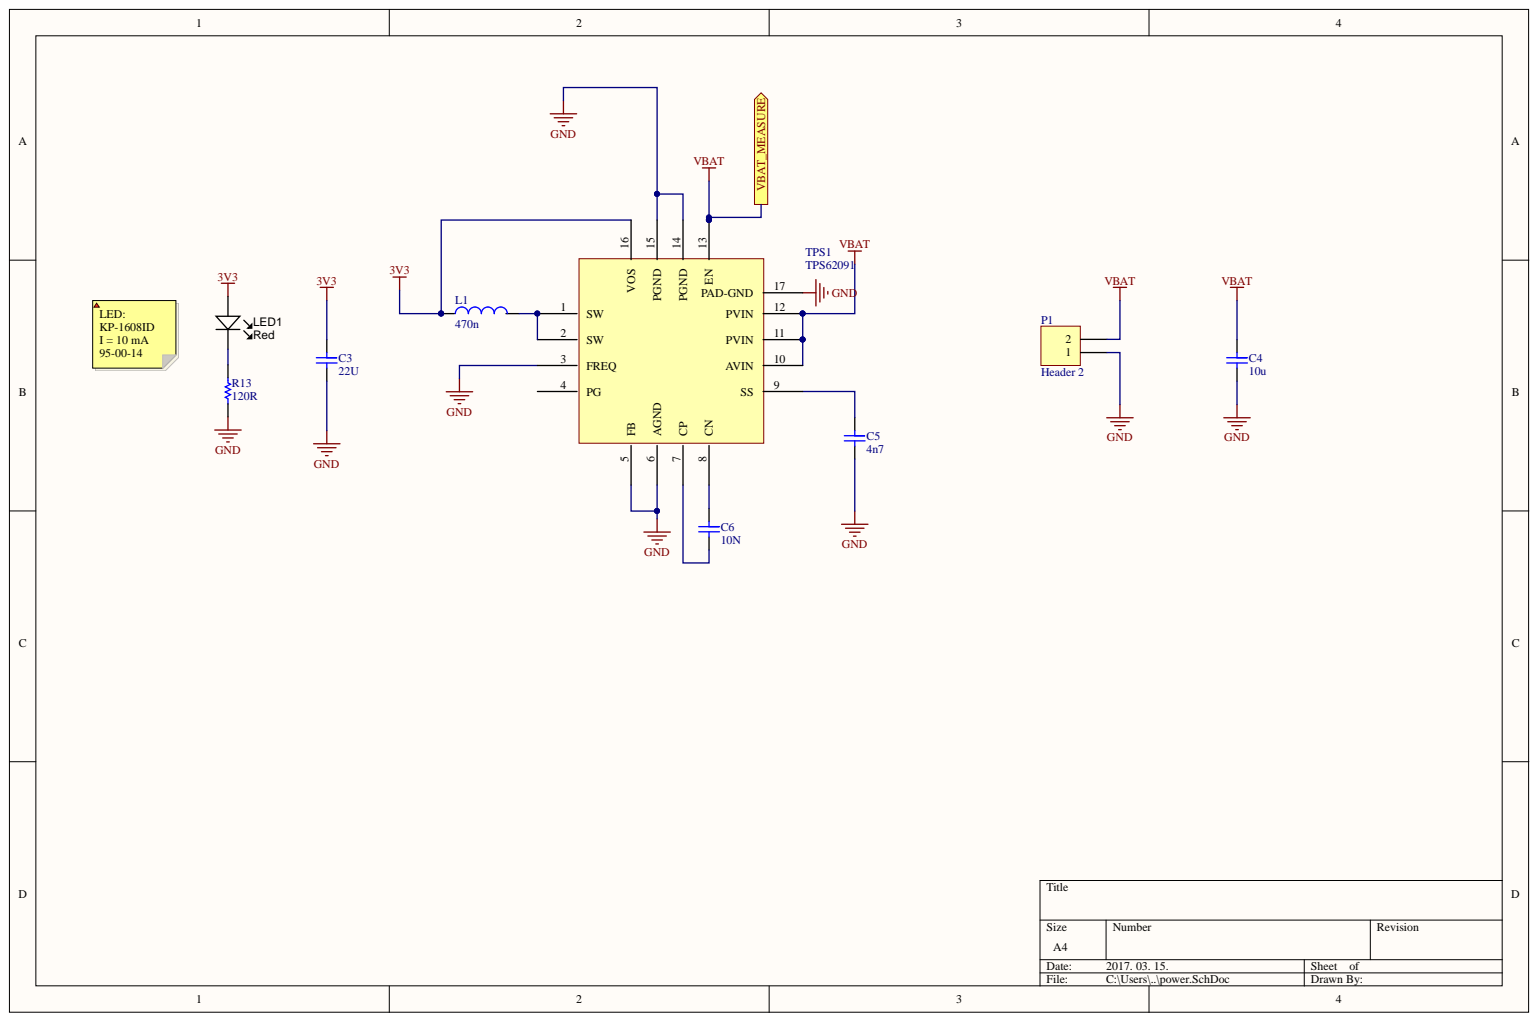
[picture p44: page 7]

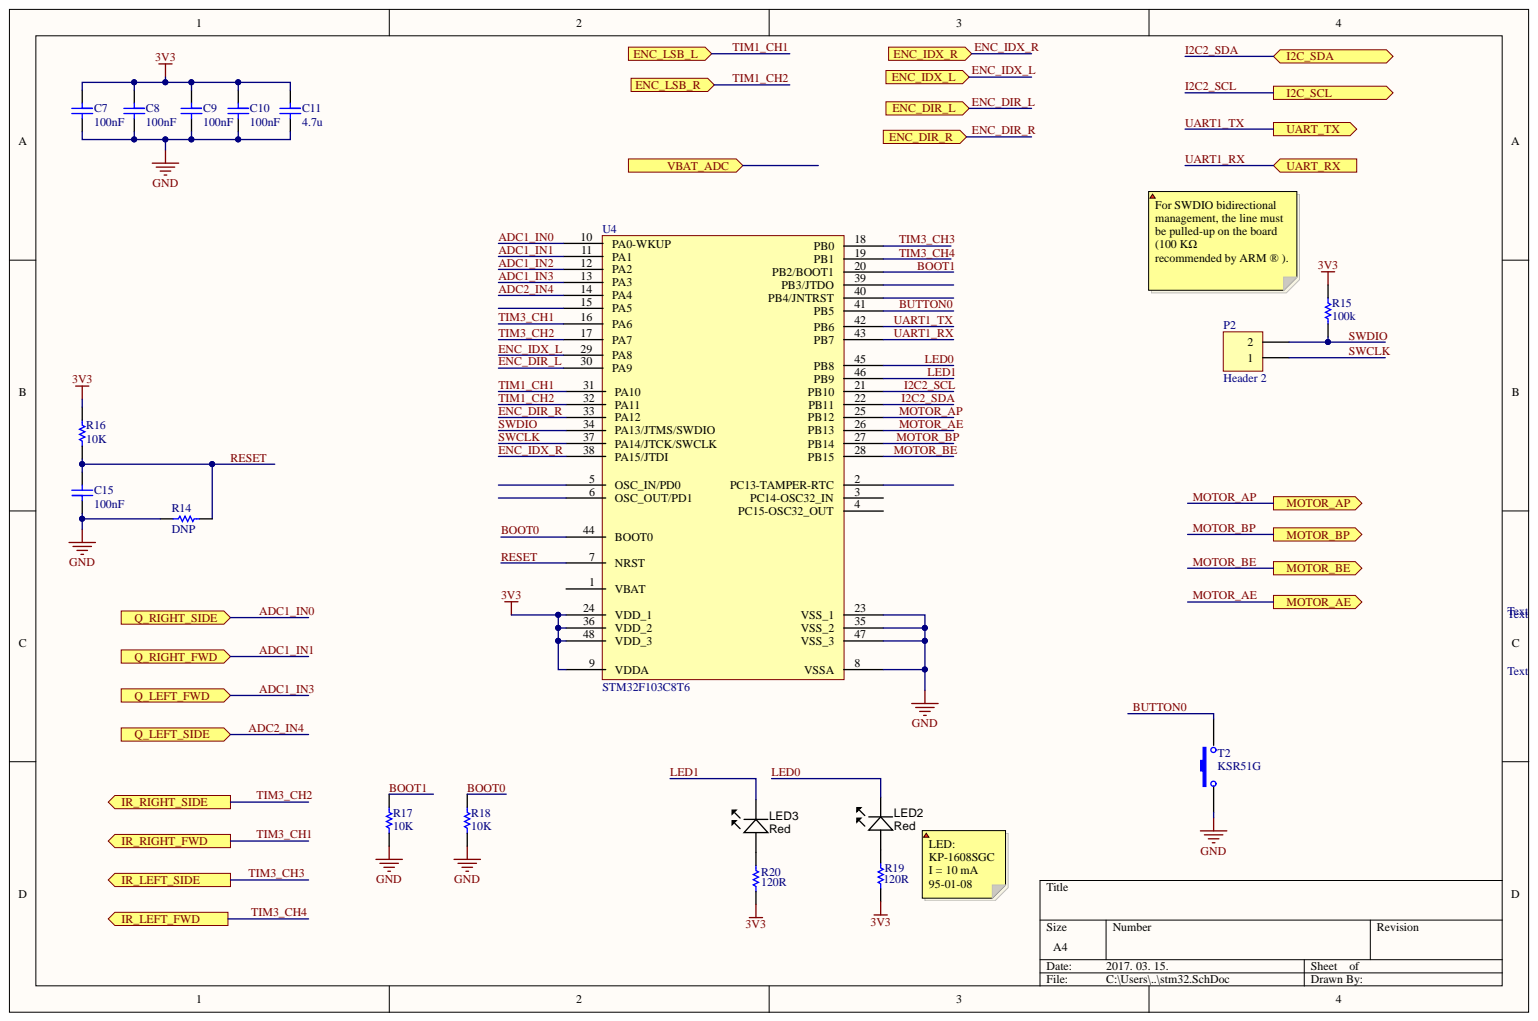
[picture p45: page 8]

For SWDIO bidirectional
management, the line must
be pulled-up on the board
recommended by ARM ® ).

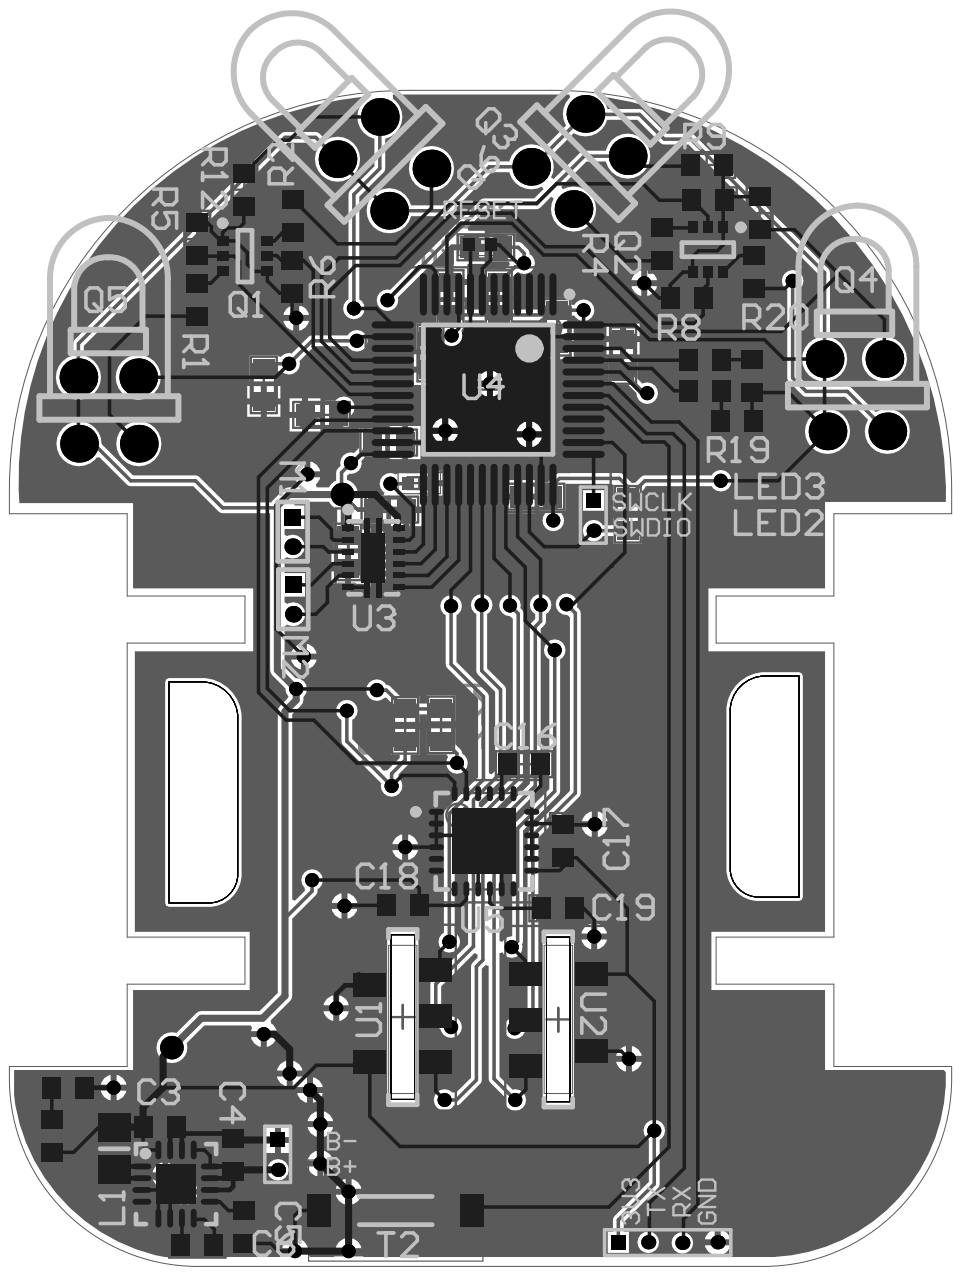
[picture p46: page 9]
