tardani95/micromouse_2019/02_pcb/mouse_codename/micromouse2019.brd

## EAGLE design 02_pcb/mouse_codename/micromouse2019.brd (2019-04-19)

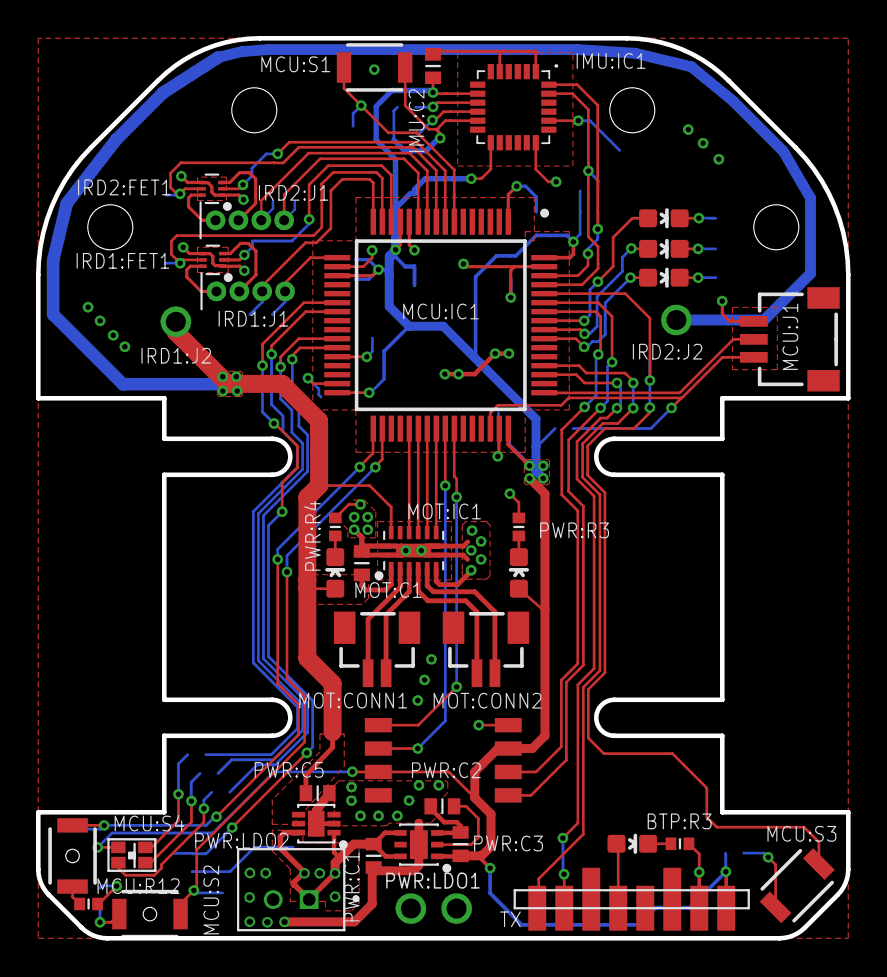
[picture p47: board micromouse2019.brd from above]

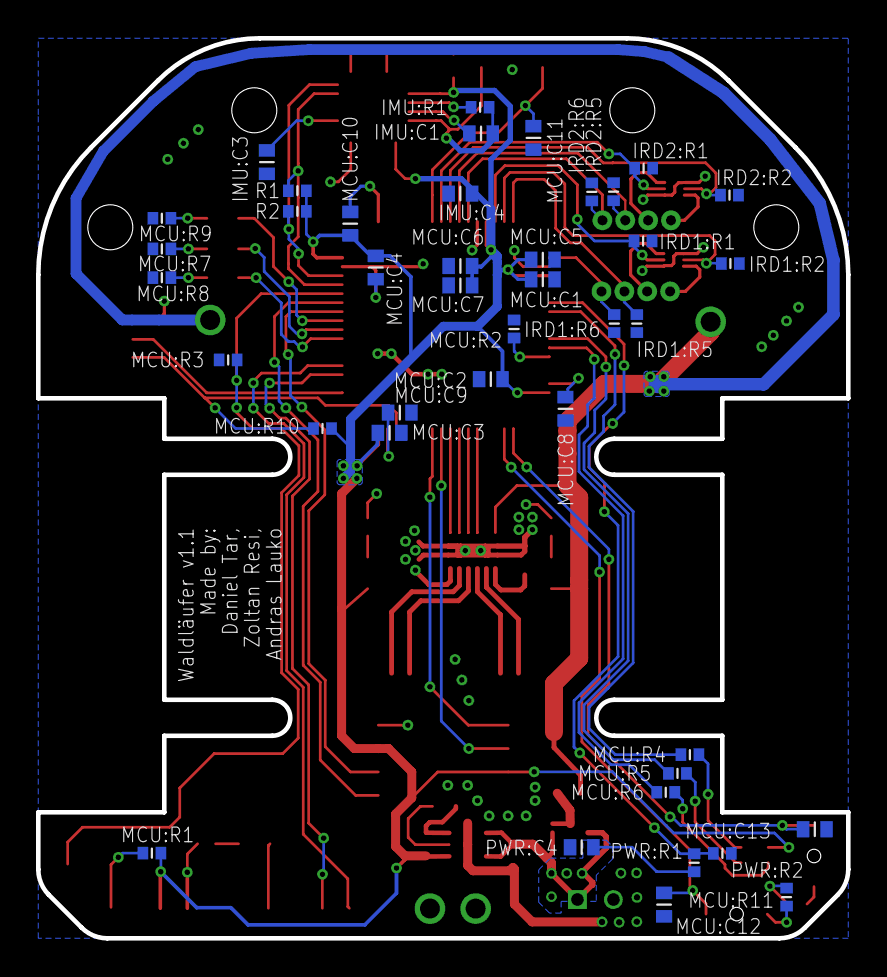
[picture p48: board micromouse2019.brd from below]

Board: 2 copper layers, 45.0 x 50.0 mm, 82 parts (41 on the bottom side), 66 nets.

Parts:
BTP:LED3: LED_B; 0603-BLUE
BTP:PORT1: PORT_BT_BASE; BT_PORT_BASE
BTP:R3: 100R; R0402
CONN1, CONN2: CONN_IRD_VCC; CONN_IRD_VCC_HDRV1W64P0_1X1_254X254X838B
EPL:PORT1: PORT_ENC_BASE; ENC_PORT_BASE
EPR:PORT1: PORT_ENC_BASE; ENC_PORT_BASE
IMU:C1, IMU:C2: 100n; C0402
IMU:C3: 2.2n; C0402
IMU:C4: 10n; C0402
IMU:IC1: IMU_MPU-6050; MPU6050
IMU:R1: 47k; R0402
IRD1:FET1, IRD2:FET1: FET_DMN2990UDJ-7; SOTFL35P100X50-6
IRD1:J1, IRD2:J1: CONN_IRDX4-P127; CONN_IRDX4_HDRV4W25P127_1X4_500X200X600B
IRD1:J2, IRD2:J2: CONN_IRD_VCC; CONN_IRD_VCC_HDRV1W64P0_1X1_254X254X838B
IRD1:R1, IRD1:R2, IRD2:R1, IRD2:R2: 10k; R0402
IRD1:R5, IRD1:R6, IRD2:R5, IRD2:R6: 2R; R0402
MCU:C1, MCU:C2, MCU:C3, MCU:C4, MCU:C6, MCU:C10, MCU:C11, MCU:C12, MCU:C13: 100n; C0402
MCU:C5: 4.7u; C0402
MCU:C7: 1u; C0402
MCU:C8, MCU:C9: 2.2u; C0402
MCU:IC1: MCU_STM32F405RGT6_L; QFP50P1200X1200X160-64N
MCU:J1: CONN_SWD; SM03B-SRSS-TB(LFSN)
MCU:LED1: LED_P; 0603-PINK
MCU:LED2: LED_G; 0603-GREEN
MCU:LED3: LED_Y; 0603-YELLOW
MCU:R1, MCU:R11, MCU:R12: 1k; R0402
MCU:R2, MCU:R3: 10k; R0402
MCU:R4, MCU:R9: 270R; R0402
MCU:R5, MCU:R6, MCU:R7, MCU:R8: 100R; R0402
MCU:R10: 100k; R0402
MCU:RGB1: LED_RGB-0603; D_RGB_0603
MCU:S1, MCU:S3: BTN_B3U-1000P; B3U-1000P
MCU:S2: BTN1; B3U-3000P
MCU:S4: BTN2; B3U-3000P
MOT:C1: 4u7; C0402
MOT:CONN1: MOTOR1; BM02B-SRSS-TB(LFSN)
MOT:CONN2: MOTOR2; BM02B-SRSS-TB(LFSN)
MOT:IC1: MOT_DRV88361; DRV8836
PWR:C1, PWR:C4: 1u; C0402
PWR:C2: 10n; C0402
PWR:C3: 2u2; C0402
PWR:C5: 10u; C0402
PWR:CONN1: CONN_BATTERY; JST_B2B-PH-K-S(LF)(SN)
PWR:LDO1: PS_TPS735DRVT; SON65P200X200X80-7T100X160
PWR:LDO2: PS_LDL112PU; SON50P200X200X80-7T92X145
PWR:LED1: LED_O; 0603-ORANGE
PWR:LED2: LED_R; 0603-RED
PWR:R1, PWR:R2: 47k; R0402
PWR:R3, PWR:R4: 270R; R0402
R1, R2: 4k7; R0402

Connections:
+3V3: BTP:PORT1.P$15, EPL:PORT1.P3, EPR:PORT1.P3, IMU:C2.1, IMU:C4.1, IMU:IC1.8, IMU:IC1.13, MCU:C1.1, MCU:C2.1, MCU:C3.1, MCU:C4.1, MCU:C5.1, MCU:C6.1, MCU:C7.1, MCU:C10.1, MCU:IC1.13, MCU:IC1.19, MCU:IC1.32, MCU:IC1.48, MCU:IC1.64, MCU:R1.2, MCU:R10.2, MCU:RGB1.P$1, PWR:C3.1, PWR:LDO1.1, PWR:LED1.A, R1.2, R2.2
BTP:BT_STATUS: BTP:LED3.A, BTP:PORT1.P$11
BTP:N$3: BTP:LED3.C, BTP:R3.2
DRV_A_IN1: MCU:IC1.37, MOT:IC1.10
DRV_A_IN2: MCU:IC1.38, MOT:IC1.9
DRV_B_IN1: MCU:IC1.39, MOT:IC1.8
DRV_B_IN2: MCU:IC1.40, MOT:IC1.7
ENC_LEFT_CHA: EPL:PORT1.P1, MCU:IC1.42
ENC_LEFT_CHB: EPL:PORT1.P2, MCU:IC1.41
ENC_RIGHT_CHA: EPR:PORT1.P1, MCU:IC1.59
ENC_RIGHT_CHB: EPR:PORT1.P2, MCU:IC1.58
GND: BTP:PORT1.P$14, BTP:R3.1, CONN1.1, CONN2.1, EPL:PORT1.P4, EPR:PORT1.P4, IMU:C1.2, IMU:C2.2, IMU:C3.2, IMU:C4.2, IMU:IC1.1, IMU:IC1.5, IMU:IC1.11, IMU:IC1.18, IMU:R1.1, IRD1:FET1.1, IRD1:FET1.4, IRD1:R1.1, IRD1:R2.1, IRD1:R5.1, IRD1:R6.1, IRD2:FET1.1, IRD2:FET1.4, IRD2:R1.1, IRD2:R2.1, IRD2:R5.1, IRD2:R6.1, MCU:C1.2, MCU:C2.2, MCU:C3.2, MCU:C4.2, MCU:C5.2, MCU:C6.2, MCU:C7.2, MCU:C8.2, MCU:C9.2, MCU:C11.2, MCU:C12.2, MCU:C13.2, MCU:IC1.12, MCU:IC1.18, MCU:IC1.63, MCU:J1.3, MCU:R2.1, MCU:R3.1, MCU:R7.2, MCU:R8.2, MCU:R9.2, MCU:R11.1, MCU:R12.1, MCU:S1.1, MOT:C1.2, MOT:IC1.6, MOT:IC1.14, MOT:IC1.15, MOT:IC1.16, MOT:IC1.17, PWR:C1.2, PWR:C2.2, PWR:C3.2, PWR:C4.2, PWR:C5.2, PWR:CONN1.2, PWR:LDO1.3, PWR:LDO1.7, PWR:LDO2.2, PWR:LDO2.7, PWR:R2.1, PWR:R3.1, PWR:R4.1
IMU:AD0: IMU:IC1.9, IMU:R1.2
IMU:CPOUT: IMU:C3.1, IMU:IC1.20
IMU:REGOUT: IMU:C1.1, IMU:IC1.10
IRD1:DRAIN_1: IRD1:FET1.6, IRD1:J1.1
IRD1:DRAIN_2: IRD1:FET1.3, IRD1:J1.2
IRD2:DRAIN_1: IRD2:FET1.6, IRD2:J1.1
IRD2:DRAIN_2: IRD2:FET1.3, IRD2:J1.2
MCU:BOOT0: MCU:IC1.60, MCU:R3.2, MCU:S3.1
MCU:BOOT1: MCU:IC1.28, MCU:R2.2
MCU:BTN1: MCU:C12.1, MCU:IC1.34, MCU:S2.1
MCU:BTN2: MCU:C13.1, MCU:IC1.33, MCU:S4.2
MCU:BTN_BOOT0: MCU:R1.1, MCU:S3.2
MCU:HEARTBEAT: MCU:IC1.55, MCU:LED2.A
MCU:LED_PINK: MCU:IC1.56, MCU:LED1.A
MCU:LED_YELLOW_SUBMARINE: MCU:IC1.57, MCU:LED3.A
MCU:N$1: MCU:R4.2, MCU:RGB1.P$2
MCU:N$2: MCU:LED1.C, MCU:R7.1
MCU:N$3: MCU:R5.2, MCU:RGB1.P$4
MCU:N$4: MCU:R6.2, MCU:RGB1.P$3
MCU:N$5: MCU:LED2.C, MCU:R8.1
MCU:N$6: MCU:LED3.C, MCU:R9.1
MCU:N$7: MCU:R11.2, MCU:S2.2
MCU:N$8: MCU:C8.1, MCU:IC1.31
MCU:N$9: MCU:R12.2, MCU:S4.1
MCU:N$10: MCU:C9.1, MCU:IC1.47
MCU:NRST: MCU:C11.1, MCU:IC1.7, MCU:S1.2
MCU:RGB_B: MCU:IC1.27, MCU:R6.1
MCU:RGB_G: MCU:IC1.26, MCU:R5.1
MCU:RGB_R: MCU:IC1.23, MCU:R4.1
MCU:SWCLK: MCU:IC1.49, MCU:J1.2
MCU:SWDIO: MCU:IC1.46, MCU:J1.1, MCU:R10.1
MCU:V_BAT: MCU:C10.2, MCU:IC1.1
MOT:AOUT1: MOT:CONN1.1, MOT:IC1.2
MOT:AOUT2: MOT:CONN1.2, MOT:IC1.3
MOT:BOUT1: MOT:CONN2.1, MOT:IC1.4
MOT:BOUT2: MOT:CONN2.2, MOT:IC1.5
unnamed: IRD1:FET1.2, IRD1:R1.2, MCU:IC1.14
unnamed: IRD1:FET1.5, IRD1:R2.2, MCU:IC1.15
unnamed: IRD1:J1.3, IRD1:R5.2, MCU:IC1.16
unnamed: IRD1:J1.4, IRD1:R6.2, MCU:IC1.17
unnamed: IRD2:FET1.2, IRD2:R1.2, MCU:IC1.8
unnamed: IRD2:FET1.5, IRD2:R2.2, MCU:IC1.9
unnamed: IRD2:J1.3, IRD2:R5.2, MCU:IC1.10
unnamed: IRD2:J1.4, IRD2:R6.2, MCU:IC1.11
PWR:N$1: PWR:C2.1, PWR:LDO1.2
PWR:N$2: PWR:LED1.C, PWR:R3.2
PWR:N$4: PWR:LED2.C, PWR:R4.2
PWR:V_BAT_IN: PWR:C1.1, PWR:C4.1, PWR:CONN1.1, PWR:LDO1.4, PWR:LDO1.6, PWR:LDO2.1, PWR:LDO2.6, PWR:R1.2
SCL: IMU:IC1.23, MCU:IC1.61, R1.1
SDA: IMU:IC1.24, MCU:IC1.62, R2.1
UART3_RX: BTP:PORT1.P$8, MCU:IC1.52
UART3_TX: BTP:PORT1.P$9, MCU:IC1.51
VCC: IRD1:J2.1, IRD2:J2.1, MOT:C1.1, MOT:IC1.1, MOT:IC1.12, PWR:C5.1, PWR:LDO2.4, PWR:LED2.A
V_BAT_LEVEL: MCU:IC1.22, PWR:R1.1, PWR:R2.2
