tardani95/micromouse_2019/02_pcb/mouse_codename/micromouse2019_enc.brd

## EAGLE design 02_pcb/mouse_codename/micromouse2019_enc.brd (2019-02-27)

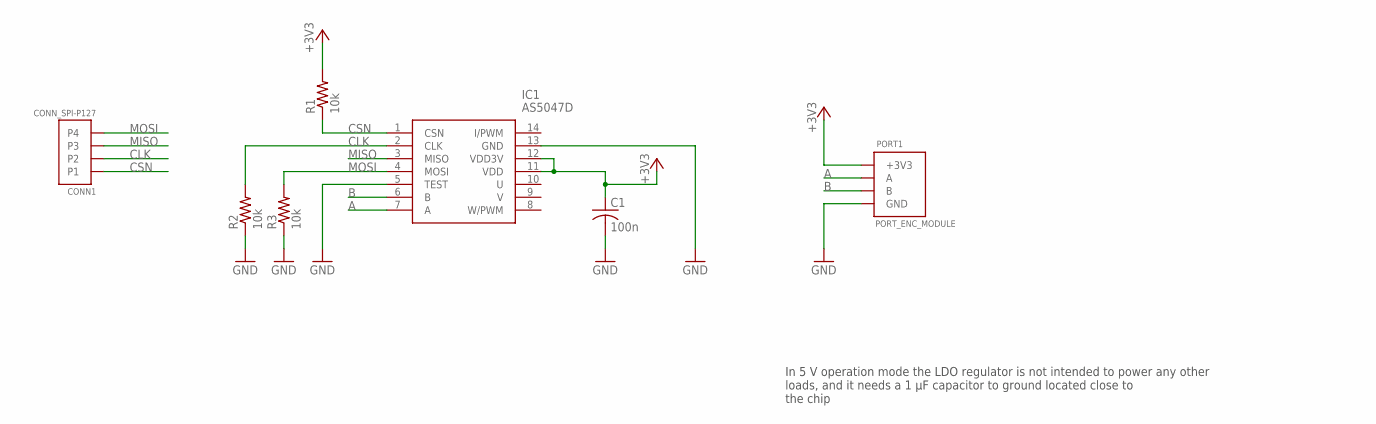
[picture p49: schematic micromouse2019_enc.sch]

Parts:
C1: 100n; C0402
CONN1: CONN_SPI-P127; CONN_SPI_HDRRA4W40P127_1X4_549X220X220B
IC1: AS5047D; SOP65P640X120-14N
PORT1: PORT_ENC_MODULE; ENC_PORT_MODULE
R1, R2, R3: 10k; R0402

Connections:
+3V3: C1.1, IC1.11 (VDD), IC1.12 (VDD3V), PORT1.P3 (+3V3), R1.2
A: IC1.7 (A), PORT1.P1 (A)
B: IC1.6 (B), PORT1.P2 (B)
CLK: CONN1.2, IC1.2 (CLK), R2.2
CSN: CONN1.1, IC1.1 (CSN), R1.1
GND: C1.2, IC1.5 (TEST), IC1.13 (GND), PORT1.P4 (GND), R2.1, R3.1
MISO: CONN1.3, IC1.3 (MISO)
MOSI: CONN1.4, IC1.4 (MOSI), R3.2

Notes on the sheet:
In 5 V operation mode the LDO regulator is not intended to power any other loads, and it needs a 1 μF capacitor to ground located close to the chip

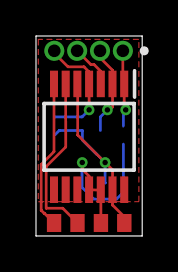
[picture p50: board micromouse2019_enc.brd from above]

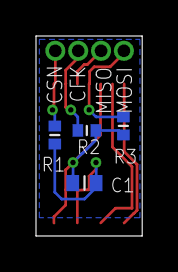
[picture p51: board micromouse2019_enc.brd from below]

Board: 2 copper layers, 5.9 x 11.1 mm, 7 parts (4 on the bottom side), 8 nets.
