tardani95/micromouse_2019/02_pcb/mouse_codename/double_ldo_design.brd

## EAGLE design 02_pcb/mouse_codename/double_ldo_design.brd (2019-02-19)

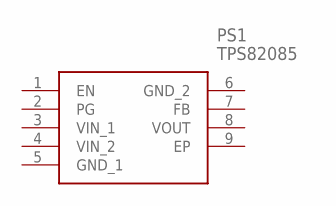
[picture p52: schematic double_ldo_design.sch, sheet 1, power supply]

Parts:
PS1: TPS82085

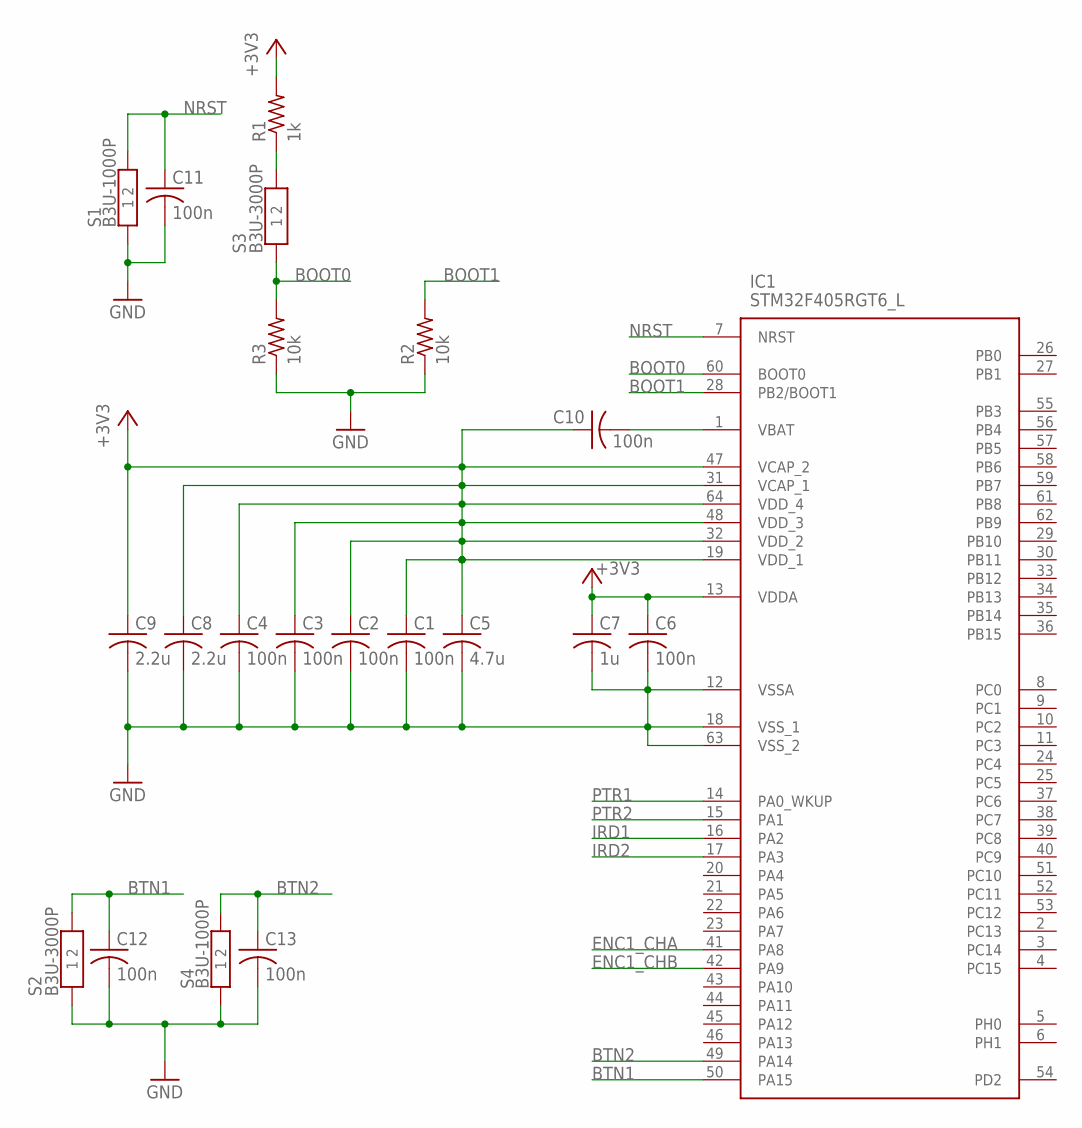
[picture p53: schematic double_ldo_design.sch, sheet 2, mcu]

Parts:
C1, C2, C3, C4, C6, C10, C11, C12, C13: 100n; C0402
C5: 4.7u; C0402
C7: 1u; C0402
C8, C9: 2.2u; C0402
IC1: STM32F405RGT6_L; QFP50P1200X1200X160-64N
R1: 1k; R0402
R2, R3: 10k; R0402
S1, S4: B3U-1000P
S2, S3: B3U-3000P

Connections:
+3V3: C1.1, C2.1, C3.1, C4.1, C5.1, C6.1, C7.1, C8.1, C9.1, C10.1, IC1.13 (VDDA), IC1.19 (VDD_1), IC1.31 (VCAP_1), IC1.32 (VDD_2), IC1.47 (VCAP_2), IC1.48 (VDD_3), IC1.64 (VDD_4), R1.2
BOOT0: IC1.60 (BOOT0), R3.2, S3.1
BOOT1: IC1.28 (PB2/BOOT1), R2.2
BTN1: C12.1, IC1.50 (PA15), S2.2
BTN2: C13.1, IC1.49 (PA14), S4.2
ENC1_CHA: IC1.41 (PA8)
ENC1_CHB: IC1.42 (PA9)
GND: C1.2, C2.2, C3.2, C4.2, C5.2, C6.2, C7.2, C8.2, C9.2, C11.2, C12.2, C13.2, IC1.12 (VSSA), IC1.18 (VSS_1), IC1.63 (VSS_2), R2.1, R3.1, S1.1, S2.1, S4.1
IRD1: IC1.16 (PA2)
IRD2: IC1.17 (PA3)
unnamed: R1.1, S3.2
unnamed: C10.2, IC1.1 (VBAT)
NRST: C11.1, IC1.7 (NRST), S1.2
PTR1: IC1.14 (PA0_WKUP)
PTR2: IC1.15 (PA1)

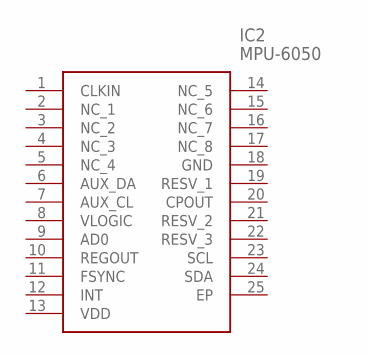
[picture p54: schematic double_ldo_design.sch, sheet 3, gyro+accel]

Parts:
IC2: MPU-6050; MPU6050

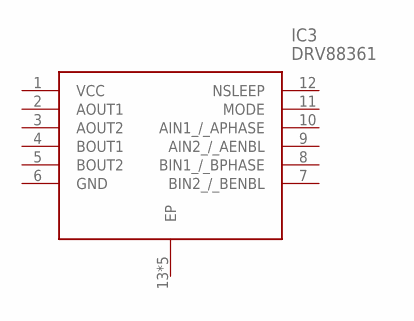
[picture p55: schematic double_ldo_design.sch, sheet 4, motor controll]

Parts:
IC3: DRV88361; DRV8836

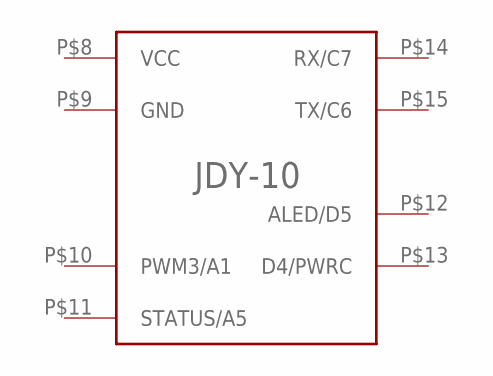
[picture p56: schematic double_ldo_design.sch, sheet 7, wireless modul]

Parts:
U$1: JDY-10_STANDING

Board: 2 copper layers, 25 parts (7 on the bottom side), 9 nets, no tracks yet.
