tardani95/micromouse_2019/03_software/embedded_sw_SPL_C/src/main.c

/**
 * @mainpage 	Micromouse 2019 - Waldläufer
 * @author 		Daniel Tar, Zoltan Resi, Andras Lauko
 * @date		11-03-2019
 *
 * here comes the code style,
 * naming conventions,
 * general information,
 *
 @verbatim
 Documentation Rules:

 For variables:
 int var; Detailed description after the member

 For functions one can use the @ param command to document the parameters and then use [in], [out], [in,out] to document the direction. For inline documentation this is also possible by starting with the direction attribute, e.g.

 * @ brief description
 * @ param v
 * @ return None

 @endverbatim

 @code
 int sum(int a, int b){
 return a+b;
 }
 @endcode

 void foo(int v << [in] docs for input parameter v. );
 */

/**
 ******************************************************************************
 * @file    main.c
 * @author  Daniel Tar, Zoltar Resi, Andras Lauko
 * @version V0.1
 * @date    11-03-2019
 * @brief   main program
 ******************************************************************************
 * @attention
 *
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
 ******************************************************************************
 */

/**
 * @defgroup micromouse2019_main main_software
 * @brief 	main()
 * @{
 */

/* Includes */
#include "stm32f4xx.h"
#include "misc.h"
#include <stdio.h>
#include <stdlib.h>

/**
 * @defgroup hardware_modules Hardware Modules
 * @{
 */
#include "hw_button.h"
#include "hw_encoder.h"
#include "hw_IMU.h"
#include "hw_motor_control.h"
#include "hw_status_led.h"
#include "hw_BT_module.h"

#include "hw_adc_module.h"

/**
 * @}
 */

/**
 * @defgroup software_modules Software Modules
 * @{
 */
#include "sw_debug.h"
#include "sw_GPTIM.h"
#include "sw_menu.h"
#include "sw_control.h"
#include "sw_localization.h"
#include "sw_trajectory_planner.h"

#include "util.h"

/**
 * @}
 */

//#define STM_EVAL /* comment this line if the stm evaluation board is not used */

#ifdef STM_EVAL
#include "stm32f4_discovery.h"
#endif

#define OnButtonPressed  EXTI15_10_IRQHandler

/* Private macro */
/* Private variables */

//uint8_t i2cRxBuffer[14] = { };
//uint8_t i2cTxBuffer[] = { 0x3B, 0x3B, 0x3B, 0x3B };
//int16_t accel_gyro_temp[7];
//float gForceX, gForceY, gForceZ;
//float rotX, rotY, rotZ;
//float temp_C;
//volatile uint16_t *adc_readings;
volatile uint8_t toggle = 1;
volatile uint8_t rgb_led_status = 0;
volatile uint8_t adsf = 1;

uint32_t enc_left;
uint32_t enc_right;
float battery_voltage;

menu_p_t main_menu_p;
menu_p_t after_run_menu_p;

/* Private function prototypes */
/* Private functions */

/**
 * @brief Initialize all peripherals\n
 * but with all interrupts disabled
 * @param None
 * @return None
 */
void Init_Periph(void) {

	initSysTick();
	init_usTimer();
	//TODO set NVIC priorities
	NVIC_PriorityGroupConfig(NVIC_PriorityGroup_4); /* 4 bit (0-15 -- the lower the higher) for preemption, and 0 bit for sub-priority */

	initStatusLEDs();
	initMotorControl();

	initADC();

	initEncoders();
//	initMenus(&main_menu_p, &after_run_menu_p);

	initBTModule();
	initIMU();
	if (setupIMU()) { /* if the communication working with the IMU, than sets the pink led for 1.5 seconds */
		setLED(LED_PINK);
		delay_ms(1500);
		resetLED(LED_PINK);
	}

	initButtons();
	initLocalization();
	initTrajectoryPlanner();
	initControl();
}

/**
 **===========================================================================
 **
 **  Abstract: main program
 **
 **===========================================================================
 */
int main(void) {
	int i = 0;

//	SystemInit(); /*startup script calls this function before main*/
	/*Remap vector table to enable debugging*/
	SCB->VTOR = 0x08008000 & (int32_t) 0x1FFFFF80;

	Init_Periph();

	UART_DMASendString2("checkpoint1\n");
	delay_ms(10);

	UART_DMASendString2("checkpoint2\n");
	UART_DMA_StartListening();

	/* Infinite loop */
	while (1) {
		i++;

		battery_voltage = ADC_getBatLvl();
		m_resetEncCnt(ENC_LEFT_TIM);
		m_resetEncCnt(ENC_RIGHT_TIM);
		delay_ms(1);
		enc_left = m_getEncCnt(ENC_LEFT_TIM);
		enc_right = m_getEncCnt(ENC_RIGHT_TIM);
		delay_us(100);
//		uint16_t *adc_readings = ADC_measureIRAll();
		//setLED(LED_PINK);
		//ADC_startIRMeasurement(MS_IRD_OFF);
		//delay_ms(2);
		//uint16_t *adc_readings = ADC_getMeasuredValues();
		//delay_ms(2);
//		while (!USART_GetFlagStatus(BT_UART, USART_FLAG_RXNE))
//			;
//
//		uint16_t data = USART_ReceiveData(BT_UART);
//
//		while (!USART_GetFlagStatus(BT_UART, USART_FLAG_TXE))
//					;
//
//		if(data == 'n'){
//			nextItem(main_menu_p);
//		}
//		else if (data == 's'){
//			selectItem(main_menu_p);
//		}
//		else if(data == 'f'){//check how big the bluetooth module buffer is. apparently works fine up to 50 bytes
//			SEND("0123456789012345678901234567890123456789012345678901234567890123456789");
//		}
//		else if(data == 'm'){
//			MATSEND("insert sensor data and stuff");
//		}
//
//		MPU6050_GetRawAccelGyro(accel_gyro_temp);
//		MPU6050_DMAGetRawAccelGyro();
//		for (uint32_t i = 0; i < 32000; i += 2) {
//			i--;
//		}

	}
}

/**
 * @brief external interrupt handler for the buttons
 */
void OnButtonPressed() {
	/**
	 * @note sometimes button 1 interrupt also gets called when button 2 is pressed
	 *  it is because we forgot to put an 1k resistor between the button and the ground
	 */

	/* button1 pressed*/
	if (SET == EXTI_GetITStatus(BTN1_EXTI_Line)) {

		//INFO("Button1 pressed");
		toggle = !toggle;
		if (!toggle) {
			/*reset encoder values*/
//			m_resetEncCnt(ENC_LEFT_TIM);
//			m_resetEncCnt(ENC_RIGHT_TIM);
			//actuateMotor(LEFT, FORWARD, 300);
			//actuateMotor(RIGHT, FORWARD, 400);
			stamp();
			ControlLoop_Cmd(ENABLE);
		} else {
			ControlLoop_Cmd(DISABLE);
			actuateMotor(LEFT, COAST, 0);
			actuateMotor(RIGHT, COAST, 0);
		}

		sendDebugData();
		rgb_led_status++;
		EXTI_ClearITPendingBit(BTN1_EXTI_Line);
	}

	/* button2 pressed*/
	if (SET == EXTI_GetITStatus(BTN2_EXTI_Line)) {

		//INFO("Button2 pressed");
		rgb_led_status++;
		EXTI_ClearITPendingBit(BTN2_EXTI_Line);
	}

	setRGB(rgb_led_status % 10);
}

/**
 * @}
 */
