tardani95/micromouse_2019/03_software/stm32f415rgt6/stm32f415rgt6.ioc

Mcu.UserName=STM32F415RGTx
PA0-WKUP.Signal=GPIO_Output
PA1.Signal=GPIO_Output
PA13.Signal=SYS_JTMS-SWDIO
PA14.Signal=SYS_JTCK-SWCLK
PA2.Signal=ADCx_IN2
PA3.Signal=ADCx_IN3
PA6.Signal=ADCx_IN6
PA7.Signal=TIM8_CH1N
PA8.Signal=S_TIM1_CH1
PA9.Signal=S_TIM1_CH2
PB0.Signal=TIM8_CH2N
PB1.Signal=TIM8_CH3N
PB12.Signal=GPXTI12
PB13.Signal=GPXTI13
PB3.Signal=GPIO_Output
PB4.Signal=GPIO_Output
PB5.Signal=GPIO_Output
PB6.Signal=S_TIM4_CH1
PB7.Signal=S_TIM4_CH2
PB8.Signal=I2C1_SCL
PB9.Signal=I2C1_SDA
PC0.Signal=GPIO_Output
PC1.Signal=GPIO_Output
PC10.Signal=USART3_TX
PC11.Signal=USART3_RX
PC2.Signal=ADCx_IN12
PC3.Signal=ADCx_IN13
PC6.Signal=S_TIM3_CH1
PC7.Signal=S_TIM3_CH2
PC8.Signal=S_TIM3_CH3
PC9.Signal=S_TIM3_CH4
