tardani95/micromouse_2019/03_software/bootloader/Source/ARMCM4_STM32F4/uart.c

/************************************************************************************//**
* \file         Source/ARMCM4_STM32F4/uart.c
* \brief        Bootloader UART communication interface source file.
* \ingroup      Target_ARMCM4_STM32F4
* \internal
*----------------------------------------------------------------------------------------
*                          C O P Y R I G H T
*----------------------------------------------------------------------------------------
*   Copyright (c) 2013  by Feaser    http://www.feaser.com    All rights reserved
*
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
* OpenBLT is distributed in the hope that it will be useful, but WITHOUT ANY WARRANTY;
* without even the implied warranty of MERCHANTABILITY or FITNESS FOR A PARTICULAR
* PURPOSE. See the GNU General Public License for more details.
*
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
* \endinternal
****************************************************************************************/

/****************************************************************************************
* Include files
****************************************************************************************/
#include "boot.h"                                /* bootloader generic header          */
#if (BOOT_COM_UART_ENABLE > 0)
#include "stm32f4xx.h"                           /* STM32 CPU and HAL header           */
#include "stm32f4xx_ll_usart.h"                  /* STM32 LL USART header              */
#include "stm32f4xx_ll_gpio.h"                   /* STM32 LL GPIO header               */



/****************************************************************************************
* Macro definitions
****************************************************************************************/
/** \brief Timeout time for the reception of a CTO packet. The timer is started upon
 *         reception of the first packet byte.
 */
#define UART_CTO_RX_PACKET_TIMEOUT_MS (255u)
/** \brief Timeout for transmitting a byte in milliseconds. */
#define UART_BYTE_TX_TIMEOUT_MS       (10u)
/* map the configured UART channel index to the STM32's USART peripheral */
#if (BOOT_COM_UART_CHANNEL_INDEX == 0)
/** \brief Set UART base address to USART1. */
#define USART_CHANNEL   USART1
#elif (BOOT_COM_UART_CHANNEL_INDEX == 1)
/** \brief Set UART base address to USART2. */
#define USART_CHANNEL   USART2
#elif (BOOT_COM_UART_CHANNEL_INDEX == 2)
/** \brief Set UART base address to USART3. */
#define USART_CHANNEL   USART3
#elif (BOOT_COM_UART_CHANNEL_INDEX == 3)
/** \brief Set UART base address to USART4. */
#define USART_CHANNEL   USART4
#elif (BOOT_COM_UART_CHANNEL_INDEX == 4)
/** \brief Set UART base address to USART5. */
#define USART_CHANNEL   USART5
#elif (BOOT_COM_UART_CHANNEL_INDEX == 5)
/** \brief Set UART base address to USART6. */
#define USART_CHANNEL   USART6
#endif


/****************************************************************************************
* Function prototypes
****************************************************************************************/
static blt_bool UartReceiveByte(blt_int8u *data);
static void     UartTransmitByte(blt_int8u data);


/************************************************************************************//**
** \brief     Initializes the UART communication interface.
** \return    none.
**
****************************************************************************************/
void UartInit(void)
{
  LL_USART_InitTypeDef USART_InitStruct;

  /* the current implementation supports USART1 - USART5. throw an assertion error in
   * case a different UART channel is configured.
   */
  ASSERT_CT((BOOT_COM_UART_CHANNEL_INDEX == 0) ||
            (BOOT_COM_UART_CHANNEL_INDEX == 1) ||
            (BOOT_COM_UART_CHANNEL_INDEX == 2) ||
            (BOOT_COM_UART_CHANNEL_INDEX == 3) ||
            (BOOT_COM_UART_CHANNEL_INDEX == 4) ||
            (BOOT_COM_UART_CHANNEL_INDEX == 5));

  /* configure UART peripheral */
  USART_InitStruct.BaudRate = BOOT_COM_UART_BAUDRATE;
  USART_InitStruct.DataWidth = LL_USART_DATAWIDTH_8B;
  USART_InitStruct.StopBits = LL_USART_STOPBITS_1;
  USART_InitStruct.Parity = LL_USART_PARITY_NONE;
  USART_InitStruct.TransferDirection = LL_USART_DIRECTION_TX_RX;
  USART_InitStruct.HardwareFlowControl = LL_USART_HWCONTROL_NONE;
  USART_InitStruct.OverSampling = LL_USART_OVERSAMPLING_16;
  /* initialize the UART peripheral */
  LL_USART_Init(USART_CHANNEL, &USART_InitStruct);
  LL_USART_Enable(USART_CHANNEL);
  UartTransmitByte(1);
  UartTransmitByte('b');
  UartTransmitByte('l');

} /*** end of UartInit ***/


/************************************************************************************//**
** \brief     Transmits a packet formatted for the communication interface.
** \param     data Pointer to byte array with data that it to be transmitted.
** \param     len  Number of bytes that are to be transmitted.
** \return    none.
**
****************************************************************************************/
void UartTransmitPacket(blt_int8u *data, blt_int8u len)
{
  blt_int16u data_index;

  /* verify validity of the len-paramenter */
  ASSERT_RT(len <= BOOT_COM_UART_TX_MAX_DATA);

  /* first transmit the length of the packet */
  UartTransmitByte(len);

  /* transmit all the packet bytes one-by-one */
  for (data_index = 0; data_index < len; data_index++)
  {
    /* keep the watchdog happy */
    CopService();
    /* write byte */
    UartTransmitByte(data[data_index]);
  }
} /*** end of UartTransmitPacket ***/


/************************************************************************************//**
** \brief     Receives a communication interface packet if one is present.
** \param     data Pointer to byte array where the data is to be stored.
** \param     len Pointer where the length of the packet is to be stored.
** \return    BLT_TRUE if a packet was received, BLT_FALSE otherwise.
**
****************************************************************************************/
int prog_max_cmd_received = 0;
static blt_bool  xcpCtoRxInProgress = BLT_FALSE;
blt_bool UartReceivePacket(blt_int8u *data, blt_int8u *len)
{
  static blt_int8u xcpCtoReqPacket[BOOT_COM_UART_RX_MAX_DATA+1];  /* one extra for length */
  static blt_int8u xcpCtoRxLength;
  static blt_int32u xcpCtoRxStartTime = 0;
  /* start of cto packet received? */
  if (xcpCtoRxInProgress == BLT_FALSE)
  {
    /* store the message length when received */
    if (UartReceiveByte(&xcpCtoReqPacket[0]) == BLT_TRUE)
    {
      if ( (xcpCtoReqPacket[0] > 0) &&
           (xcpCtoReqPacket[0] <= BOOT_COM_UART_RX_MAX_DATA) )
      {
        /* store the start time */
        xcpCtoRxStartTime = TimerGet();
        /* reset packet data count */
        xcpCtoRxLength = 0;
        /* indicate that a cto packet is being received */
        xcpCtoRxInProgress = BLT_TRUE;
        if(xcpCtoReqPacket[0] == 64){
          prog_max_cmd_received = 1;
          LL_GPIO_SetOutputPin(GPIOB, LL_GPIO_PIN_5);
        }
        else if(prog_max_cmd_received == 1){
          prog_max_cmd_received = 1;
          LL_GPIO_SetOutputPin(GPIOB, LL_GPIO_PIN_4);
        }
      }
    }
  }
  else
  {
    /* store the next packet byte */
    if (UartReceiveByte(&xcpCtoReqPacket[xcpCtoRxLength+1]) == BLT_TRUE)
    {
      /* increment the packet data count */
      xcpCtoRxLength++;

      /* check to see if the entire packet was received */
      if (xcpCtoRxLength == xcpCtoReqPacket[0])
      {
        /* copy the packet data */
        CpuMemCopy((blt_int32u)data, (blt_int32u)&xcpCtoReqPacket[1], xcpCtoRxLength);
        /* done with cto packet reception */
        xcpCtoRxInProgress = BLT_FALSE;
        /* set the packet length */
        *len = xcpCtoRxLength;
        /* packet reception complete */

        return BLT_TRUE;
      }
    }
    else
    {
      /* check packet reception timeout */
      if (TimerGet() > (xcpCtoRxStartTime + UART_CTO_RX_PACKET_TIMEOUT_MS))
      {
        /* cancel cto packet reception due to timeout. note that that automaticaly
         * discards the already received packet bytes, allowing the host to retry.
         */
        xcpCtoRxInProgress = BLT_FALSE;
      }
    }
  }
  /* packet reception not yet complete */
  return BLT_FALSE;
} /*** end of UartReceivePacket ***/


/************************************************************************************//**
** \brief     Receives a communication interface byte if one is present.
** \param     data Pointer to byte where the data is to be stored.
** \return    BLT_TRUE if a byte was received, BLT_FALSE otherwise.
**
****************************************************************************************/
static blt_bool UartReceiveByte(blt_int8u *data)
{
  if (LL_USART_IsActiveFlag_RXNE(USART_CHANNEL) != 0)
  {
    /* retrieve and store the newly received byte */
    *data = LL_USART_ReceiveData8(USART_CHANNEL);
    /* all done */
    return BLT_TRUE;
  }
  /* still here to no new byte received */
  return BLT_FALSE;
} /*** end of UartReceiveByte ***/


/************************************************************************************//**
** \brief     Transmits a communication interface byte.
** \param     data Value of byte that is to be transmitted.
** \return    none.
**
****************************************************************************************/
static void UartTransmitByte(blt_int8u data)
{
  blt_int32u timeout;

  /* write byte to transmit holding register */
  LL_USART_TransmitData8(USART_CHANNEL, data);
  /* set timeout time to wait for transmit completion. */
  timeout = TimerGet() + UART_BYTE_TX_TIMEOUT_MS;
  /* wait for tx holding register to be empty */
  while (LL_USART_IsActiveFlag_TXE(USART_CHANNEL) == 0)
  {
    /* keep the watchdog happy */
    CopService();
    /* break loop upon timeout. this would indicate a hardware failure. */
    if (TimerGet() > timeout)
    {
      break;
    }
  }
} /*** end of UartTransmitByte ***/
#endif /* BOOT_COM_UART_ENABLE > 0 */


/*********************************** end of uart.c *************************************/
