tardani95/micromouse_2019/(commit log)

2019-02-12 previous schematic and bom excel added
    [bom.xlsx]
2019-02-12 eagle schematic and board layout added
    [dcdc_design.brd, dcdc_design.sch]
2019-02-12 eagle board layout synced with fuison 360
    [dcdc_design.brd, dcdc_design.sch]
2019-02-12 updated eagle files
    [dcdc_design.brd, dcdc_design.sch]
2019-02-14 pcb updated library added
    [dcdc_design.brd]
2019-02-14 datasheets updated
    [encoders_comparison.xlsx]
2019-02-14 power consumption calculation
2019-02-14 3d files updated + added
    [B3U-1000P.stp, B3U-3000P.stp, DRV8836DSSR.stl, DRV8836DSSR.stp, MK06_4R5_1.SLDPRT, STM32F405RGT6.stl, STM32F405RGT6.stp, _ASSEMBLY_getriebe_rechts.SLDASM]
2019-02-14 pcb board synced
    [dcdc_design.brd]
2019-02-14 datasheets added, pcb libraries added
2019-02-19 3d modells added, updated
    [BC832--3DModel-STEP-56544.STEP, DRV8836DSSR.stl, DRV8836DSSR.stp, JDY-10.stp, STM32F405RGT6.stl, STM32F405RGT6.stp]
2019-02-19 eagle libraries updated, internal OC set with PLL
    [dcdc_design.brd, dcdc_design.sch]
2019-02-19 pcb design updated
    [dcdc_design.sch, double_ldo_design.brd, double_ldo_design.sch]
2019-02-19 pcb updated
    [double_ldo_design.brd, double_ldo_design.sch]
2019-02-20 Module tree model created
    [micromouse2019.brd, micromouse2019.sch]
2019-02-20 mcu sheet updated
    [double_ldo_design.sch]
2019-02-20 frames added
    [micromouse2019.sch]
2019-02-20 pins connected to buses
    [micromouse2019.brd, micromouse2019.sch]
2019-02-20 battery voltage note added
    [micromouse2019.sch]
2019-02-20 imu sheet updated
    [micromouse2019.brd, micromouse2019.sch]
2019-02-20 serial wire debug added, buttons moved to another pin
2019-02-20 swd added
    [micromouse2019.brd, micromouse2019.sch]
2019-02-20 f405 compatible processor, and additional notes on mcu
    [micromouse2019.sch]
2019-02-20 dumy ir_ptr connector
    [micromouse2019.brd, micromouse2019.sch]
2019-02-20 connectors moved
    [micromouse2019.brd]
2019-02-20 Part files added, schematic created
    [micromouse2019.brd, micromouse2019.sch]
2019-02-20 .sch file repaired
    [micromouse2019.brd, micromouse2019.sch]
2019-02-20 updated libraries
    [micromouse2019.sch]
2019-02-20 LDO footprints updated
    [micromouse2019.brd, micromouse2019.sch]
2019-02-20 PCB layout guidelines added
    [micromouse2019.sch]
2019-02-20 Added step files for LDL and B2B
    [B2B-PH-K-S(LF)(SN)--3DModel-STEP-56544.STEP, LDL112PU33R.STEP]
2019-02-20 added encoder schematic to project
    [micromouse2019_enc.sch]
2019-02-21 mosFET & IRLED_DRIVER added
    mosFET added to lib
    IRLED_DRIVER sheet added
    [micromouse2019.brd, micromouse2019.sch]
2019-02-21 schematic and pcb created
    [micromouse2019_enc.brd, micromouse2019_enc.sch]
2019-02-21 prepared for merge
    [micromouse2019.brd]
2019-02-21 prepared for megre
    [micromouse2019.brd]
2019-02-21 components moved upwards
    [micromouse2019.brd]
2019-02-21 pcb updated with 3d components
    [B2B-PH-K-S(LF)(SN)--3DModel-STEP-56544.STEP, BM04B-SRSS-TB.STEP, LDL112PU33R.STEP, micromouse2019.brd, micromouse2019.sch]
2019-02-21 motor connector 3d file added
    [BM02B-SRSS-TB.STEP]
2019-02-21 3d modell files added
    [02SR-3S.STEP, 03SR-3S.STEP, 04SR-3S.STEP, SM03B-SRSS-TB.STEP]
2019-02-21 main library updated with connectors
    [micromouse2019.brd, micromouse2019.sch]
2019-02-21 motor sheet done + jlcpcb design rules
    [micromouse2019.brd, micromouse2019.sch]
2019-02-21 parts moved
    [micromouse2019.brd]
2019-02-21 fusion 360 synced
    [micromouse2019.brd]
2019-02-22 Updated enc pcb, spi connector added
    [micromouse2019_enc.brd, micromouse2019_enc.sch]
2019-02-22 enc PCB with correct measures
    [micromouse2019_enc.brd]
2019-02-22 GND polygons added
    [micromouse2019_enc.brd]
2019-02-22 Names and values on PCB arranged, values for R and C elements added
    [micromouse2019_enc.brd, micromouse2019_enc.sch]
2019-02-22 increased size of enc port smds
    [micromouse2019_enc.brd, micromouse2019_enc.sch]
2019-02-22 modules and buses
    [micromouse2019.brd, micromouse2019.sch]
2019-02-22 encoder base moved to its place on pcb
    [micromouse2019.brd]
2019-02-22 IR_PTR power supply voltage changed to VCC (bigger LDO)
    [micromouse2019.brd, micromouse2019.sch]
2019-02-22 moduls connected
    [micromouse2019.brd, micromouse2019.sch]
2019-02-22 bom file added - minior changes to pcb
    [bom.xlsx, micromouse2019.brd, micromouse2019.sch]
2019-02-22 encoder pcb updated
    [micromouse2019_enc.brd, micromouse2019_enc.sch]
2019-02-22 motor mode CHANGED to IN/IN, an PINs moved
2019-02-22 bat volt divider added, motor interface changed to IN/IN
    [micromouse2019.brd, micromouse2019.sch]
2019-02-22 encoder 3d file added to pcb
    [micromouse2019.brd, micromouse2019.sch]
2019-02-22 encoder moved to positon
    [micromouse2019.brd, micromouse2019.sch]
2019-02-22 top level cosmetics
    [micromouse2019.brd, micromouse2019.sch]
2019-02-23 LDO comments
    [micromouse2019.brd, micromouse2019.sch]
2019-02-23 rgb led added to cubeMX
2019-02-23 schematic and board updated with the new common library
    [micromouse2019.brd, micromouse2019.sch]
2019-02-23 encoder ic addet to pcb lib
2019-02-23 Connectors added: IRD & IRDVCC & SPI
2019-02-23 encoder board libs replaced with 0-micromouse.lbr
    [micromouse2019_enc.brd, micromouse2019_enc.sch]
2019-02-23 Connectors replaced: IRDx4 & IRDVCC & SPI
    [micromouse2019.brd, micromouse2019.sch, micromouse2019_enc.brd, micromouse2019_enc.sch]
2019-02-23 rgb led added
    [micromouse2019.brd, micromouse2019.sch]
2019-02-23 frame removed
2019-02-23 mcu condensator moved to position
    [micromouse2019.brd, micromouse2019.sch]
2019-02-23 JDY changed to BT_PORT
    [micromouse2019.brd, micromouse2019.sch]
2019-02-23 components moved to about position
    [micromouse2019.brd]
2019-02-23 leds added
    [micromouse2019.brd, micromouse2019.sch]
2019-02-23 second phase routing
    [micromouse2019.brd, micromouse2019.sch]
2019-02-24 Enc pcb updated, design rules trace to dim updated
    [micromouse2019.brd, micromouse2019.sch, micromouse2019_enc.brd, micromouse2019_enc.sch]
2019-02-24 updated all connectors
    [micromouse2019.brd, micromouse2019.sch]
2019-02-24 IR LED module name shorter, resistor value corrections
    [micromouse2019.brd, micromouse2019.sch]
2019-02-24 BT_PORT_BASE updated
    [micromouse2019.brd, micromouse2019.sch, micromouse2019_enc.brd, micromouse2019_enc.sch]
2019-02-24 UART indicator LEDs removed
    [micromouse2019.brd, micromouse2019.sch]
2019-02-24 IRD connectors repaired, IRD module split into 2
    [micromouse2019.brd, micromouse2019.sch]
2019-02-24 IRD sheet notes added
    [micromouse2019.sch]
2019-02-24 BTN_3000P drill added
2019-02-24 third phase routing
    [micromouse2019.brd]
2019-02-24 BTN_3000p drill size corrected
2019-02-24 BT adapter PCB created
    [micromouse2019.brd, micromouse2019.sch, micromouse2019_bt.brd, micromouse2019_bt.sch]
2019-02-24 replaced pins
    [micromouse2019.brd, micromouse2019.sch]
2019-02-24 LED & R & C footprint updated
2019-02-24 GPIO LEDs
2019-02-24 MOT_DRV footprint updated (therm)
2019-02-25 vcc routed
    [micromouse2019.brd, micromouse2019.sch]
2019-02-25 lib updated
    [micromouse2019.brd, micromouse2019.sch]
2019-02-25 pcb route 4th phase
    [micromouse2019.brd, micromouse2019.sch]
2019-02-25 pcb routing alpha v1_0
    [micromouse2019.brd, micromouse2019.sch]
2019-02-25 button fix, drv8836 exposed pad fix
    [micromouse2019.brd, micromouse2019.sch]
2019-02-25 bt_port tx rx changed
    [micromouse2019.brd, micromouse2019.sch, micromouse2019_bt.brd, micromouse2019_bt.sch]
2019-02-25 Schematic approved by Zoli. IMU2 Removed. RGB attributes added
    [micromouse2019.brd, micromouse2019.sch]
2019-02-25 module names shorter
    [micromouse2019.brd, micromouse2019.sch]
2019-02-25 fets moved downwards
    [micromouse2019.brd, micromouse2019.sch]
2019-02-25 LED 3D models added
2019-02-25 FET & LDO 3D models added
2019-02-25 leds updated
    [micromouse2019.brd, micromouse2019.sch]
2019-02-25 3d packages update
    [micromouse2019.brd, micromouse2019.sch]
2019-02-25 FET footprint repaired
2019-02-25 Libs updated
    [micromouse2019.brd, micromouse2019.sch]
2019-02-25 MOT_DRV mode pin changed to IN/IN
    [micromouse2019.brd, micromouse2019.sch]
2019-02-25 CONN_SPI 3d model added
    [micromouse2019_enc.brd, micromouse2019_enc.sch]
2019-02-25 ratnest pcb pushed to fusion
    [micromouse2019.brd, micromouse2019.sch]
2019-02-25 ENC A B channels repaired
    [micromouse2019_enc.brd, micromouse2019_enc.sch]
2019-02-25 mot drv wire stub removed
    [micromouse2019.brd]
2019-02-26 100k resistor added to SWDIO for bidirectional managment
    [micromouse2019.brd, micromouse2019.sch]
2019-02-26 Footprint text size set 32 mil
2019-02-26 tNames sized and placed to position
    [micromouse2019.brd, micromouse2019.sch]
2019-02-26 drc rule check ok
    [micromouse2019.brd, micromouse2019.sch]
2019-02-26 module pcbs updated
    [micromouse2019_bt.brd, micromouse2019_bt.sch, micromouse2019_enc.brd]
2019-02-26 3D modells updated
    [DRV8836DSSR.stl, DRV8836DSSR.stp, LED 0606 tri-color.stp, encoder_pcb_fusion_v4.step, micromouse2019_enc v6.stl, micromouse2019_enc v7.step]
2019-02-26 Button footprint points removed
2019-02-26 datasheets updated 2
    [LED_resistor_calculator.xlsx, connectors.xlsx]
2019-02-26 FET thermal ground added & LDOs & FET variant names corrected
    [micromouse2019.brd, micromouse2019.sch]
2019-02-26 mpu 6050 library fixed
    [micromouse2019.brd, micromouse2019.sch]
2019-02-26 mpu6050 board layout fix
    [micromouse2019.brd, micromouse2019.sch]
2019-02-26 board updated, strange polygon clearances
    [micromouse2019.brd, micromouse2019.sch]
2019-02-26 top ground plane isolate set
    [micromouse2019.brd]
2019-02-26 extra polygon deleted
    [micromouse2019.brd]
2019-02-26 I2C pull up resistors added
    [micromouse2019.brd, micromouse2019.sch]
2019-02-26 I2C pull up R on bottom & GND connection
    [micromouse2019.brd]
2019-02-26 DRV Nsleep Vcc connect
    [micromouse2019.brd, micromouse2019.sch]
2019-02-26 IMU EP removed & MCU_C11 & GND plane position adjustments
    [micromouse2019.brd, micromouse2019.sch]
2019-02-27 Bogyo removed
    [micromouse2019.sch]
2019-02-27 DRVCapacitor replaced & vias repositioned
    [micromouse2019.brd, micromouse2019.sch]
2019-02-27 enc spi texts
    [micromouse2019_enc.brd]
2019-02-27 enc spi texts v2
    [micromouse2019_enc.brd]
2019-02-27 minior fixes
    [micromouse2019.brd]
2019-02-27 some updates
    [micromouse2019_enc.brd, micromouse2019_enc.sch]
2019-02-27 minor board updates
    [micromouse2019_bt.brd]
2019-02-27 bt tx text repositioned
    [micromouse2019_bt.brd, micromouse2019_bt.sch]
2019-02-27 text repositioning
    [micromouse2019.brd]
2019-02-27 lipo battery comarision added
    [batteries.xlsx]
2019-03-06 dma set in cubeMX
2019-03-06 doxygen setup + library folder fix
    [main.c]
2019-03-11 #10 - button handling done
2019-03-12 encoder init code added
2019-03-13 status leds initialization added
2019-03-13 st_led code fixes, motor_ctrl init and basic ctrl fnc added
2019-03-14 mpu6050 i2c test done
2019-03-15 button init fixed
2019-03-15 LED pwm fixed (wasnt easy)
    [main.c]
2019-03-15 motor control working
2019-03-15 encoder interface working
2019-03-19 uart communication pc targets added
2019-03-28 imu test initial commit
2019-03-29 system core clock fixed - i2c working perfectly
    [main.c]
2019-03-29 all peripheral enabled - button2 messing with button1
2019-03-29 v_cap condesators connection fixed + name and made by texts added
    [micromouse2019.brd, micromouse2019.sch]
2019-04-10 works with polling dma flags
2019-04-10 works without clearing the uart tc flag
2019-04-10 works with dma interrupt
2019-04-10 fully works with dma it
2019-04-11 uart dma checked
2019-04-12 uart rx and tx with dma
    receive first data length then data
2019-04-12 uart dma handling moved to it's lib files
2019-04-12 dma fifo enabled - optimized string handling
2019-04-13 bootloader configured for stm32f407vg
2019-04-13 new imu lib and fixed an error in old one
    [main.c]
2019-04-13 imu dma communication works
2019-04-13 imu datasheets added
2019-04-13 uart dma init cleaned up a bit
2019-04-13 i2c dma fifo enabled
2019-04-13 main cleaned up and half word fifo added to i2c - need to fix
    [main.c]
2019-04-13 halfword fifo is not possible because DMA controller only copes with little-endian addressing
2019-04-13 old IMU lib replaced with new one
    [main.c]
2019-04-19 1k resistor needed to put between the buttons and the ground
2019-04-19 button fix on pcb
    [micromouse2019.brd, micromouse2019.sch]
2019-04-19 resistors repositioned
    [micromouse2019.brd]
2019-05-15 motors tested - actuateMotors function fault - with pure timers working
2019-05-15 encoder interface init function fixed
    [main.c]
2019-05-15 encoders counting direction fixed
2019-05-16 adc testing for each channel
2019-05-17 IR led order fix
    [main.c]
2019-05-17 adc bug - with single mod working, discontinuous mode not
    [main.c]
2019-05-19 adc discontinous mode fixed
2019-05-19 motor control pwm frequency corrected to 1kHz
2019-05-20 new motor control functions
2019-05-20 dummy control loop for encoders, button exti toggle fix
    [main.c]
2019-05-20 IR LED needs a 10-25us rise time
2019-05-21 adc common lib added
2019-05-21 IR module and batLvlWatcher encapsulated in ADC module
2019-05-21 status LED modifier functions structure changed
2019-05-21 low level and shutdown voltage irq handler created
2019-05-21 adc end of conversion interrupt set and delay with timer prepared
2019-05-21 IR sensors working with non polling state machine with interrupts
2019-05-21 updated voltage levels
2019-05-22 adc timer corrected according to measurements
    [main.c]
2019-05-22 status led modifier functions speed up with direct register access
2019-05-22 doxygen adc modul update
2019-05-22 measurements with IMU
2019-05-22 us polling timer added to util
2019-05-22 cubemx timers added
2019-05-23 new uart sending functions
2019-06-20 sending on uart thru cyclical data buffer
2019-06-24 soha jobb még nem volt a bootloader
2019-08-04 encoder odometry added
