tardani95/micromouse_2019/(notices)

Notices in the files:
03_software/bootloader/Source/xcp.h:
modify it under the terms of the GNU General Public License as published by the Free
